H0N3YC4T/prototype-mk1/docs/keymap/keymap.png

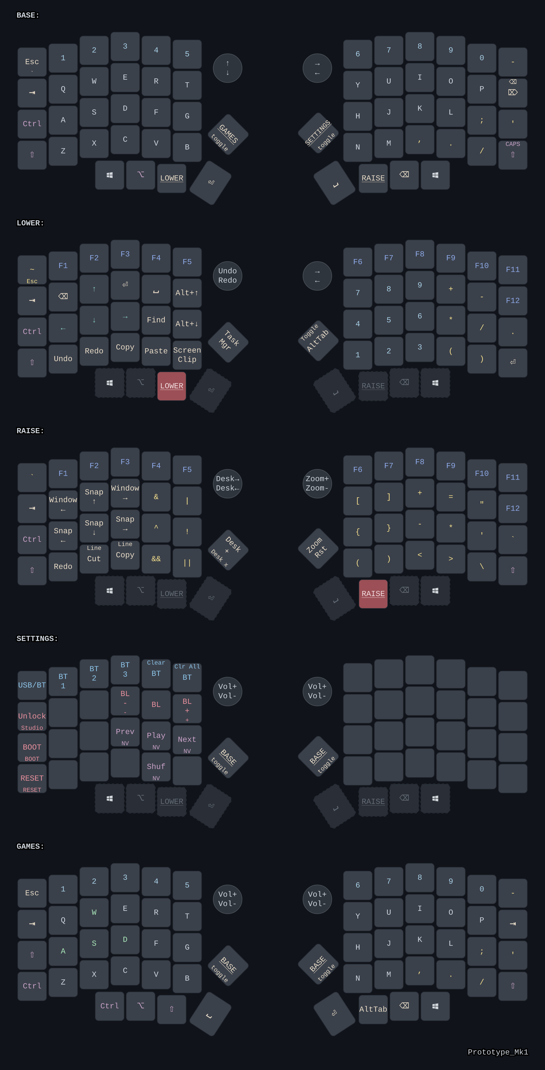
docs/keymap/keymap.png
