H0N3YC4T/prototype-mk1/docs/3d/keyboard.3mf

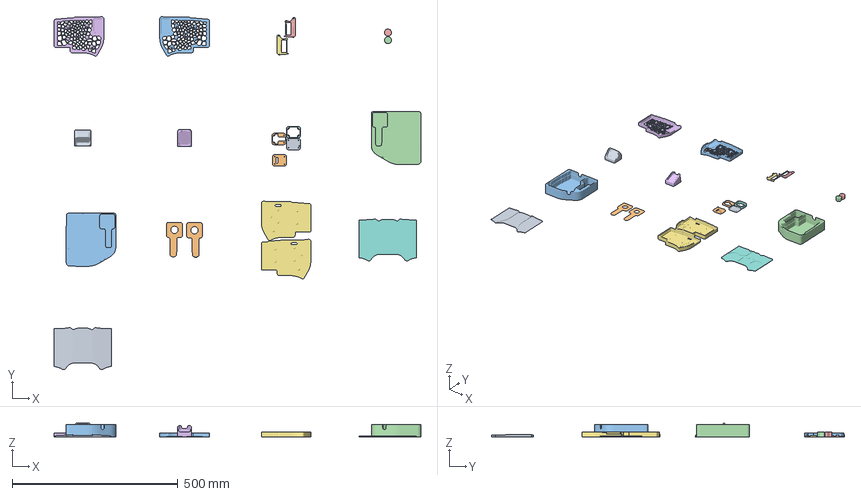
[picture p2: CAD file, 2026-10-10]
docs/3d/keyboard.3mf
1107.8 x 1066.5 x 43.7 mm
Assembly x 4
base x 2
dock_portrait
disp_mount.stl
Back
Middle
Keyboard_base
Body1_B x 2
Base - Part 8.stl
Base - Part 9.stl
