H0N3YC4T/prototype-mk1/docs/kicad_pcb.pdf

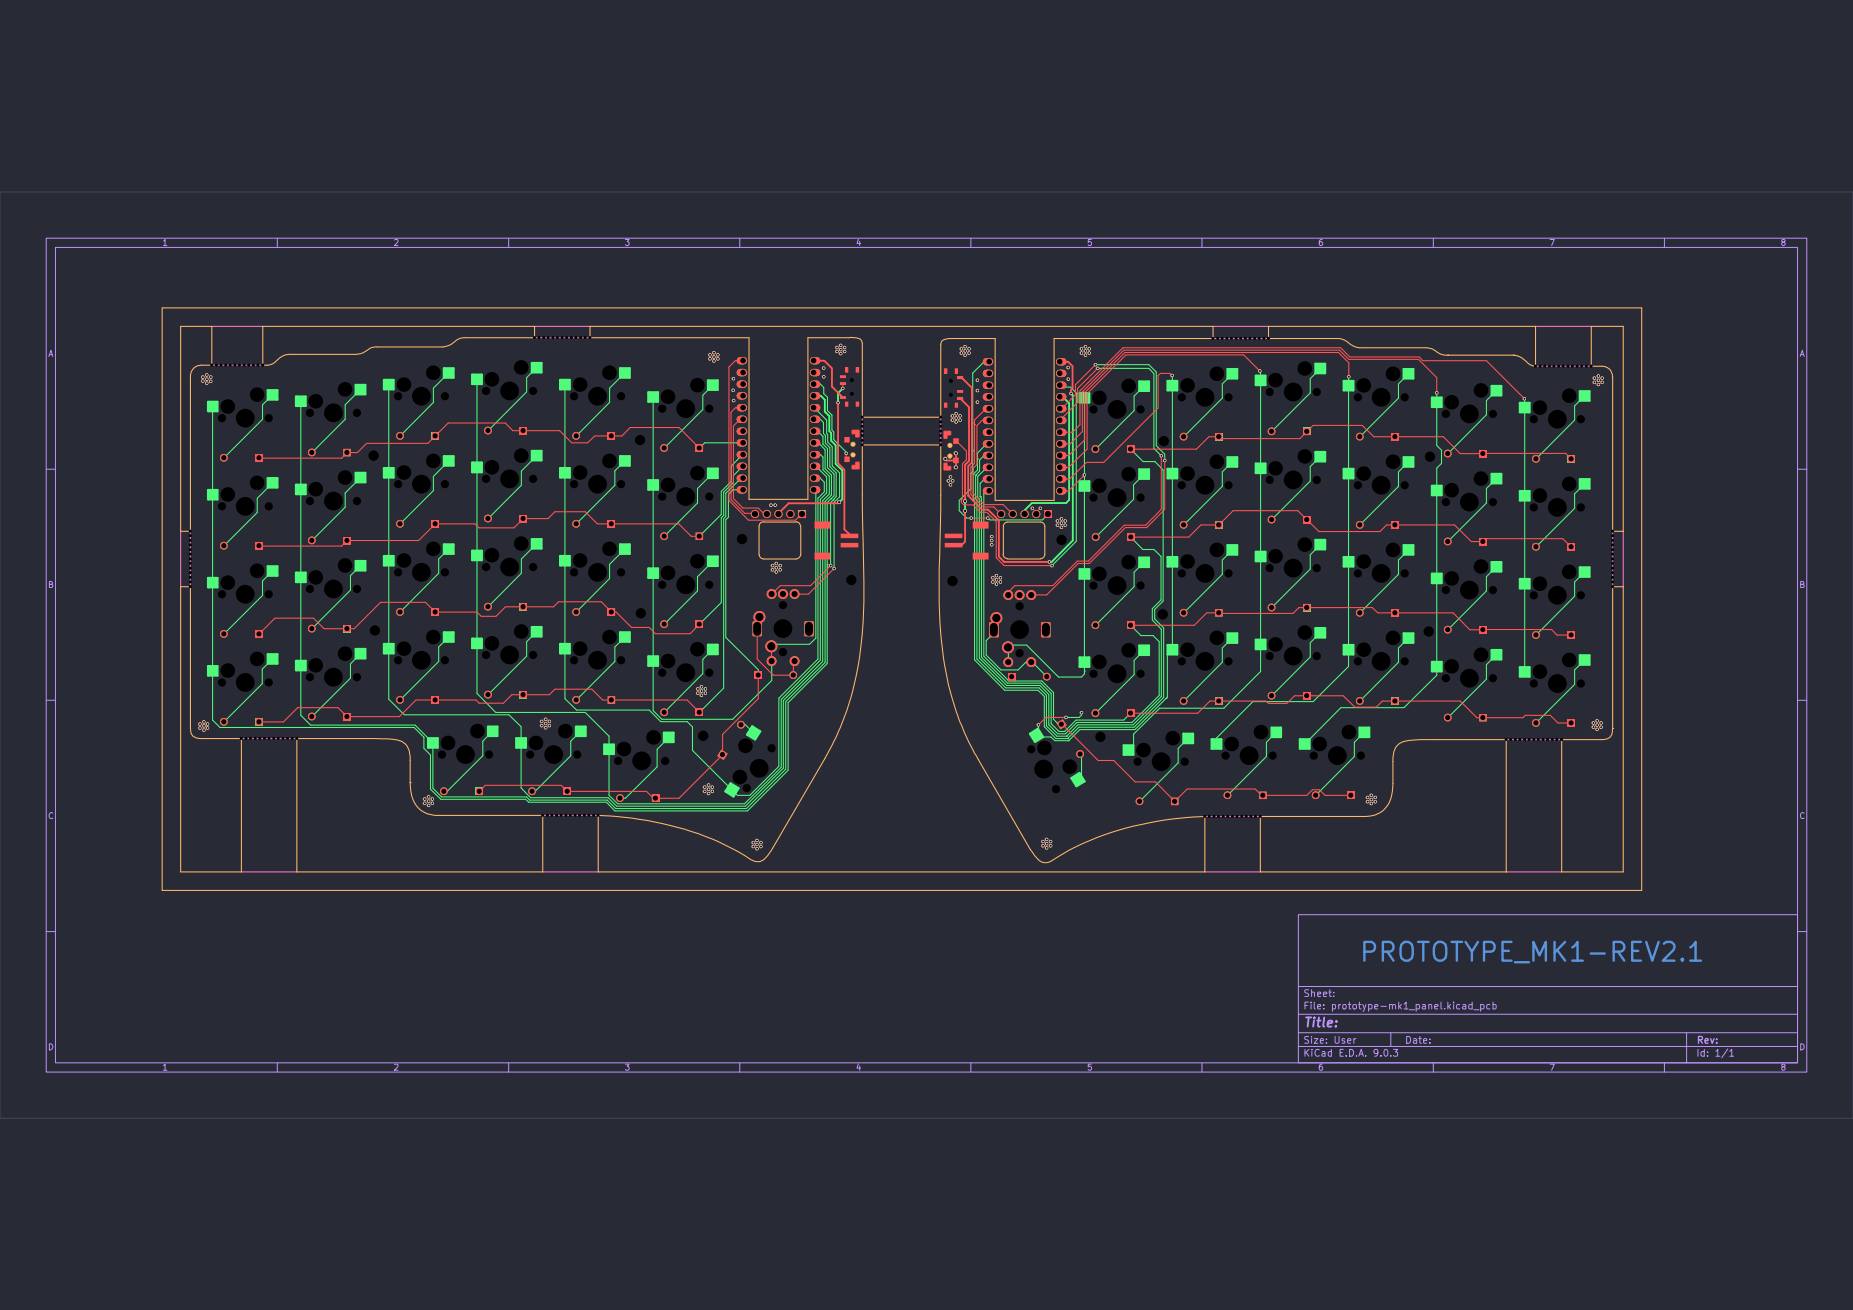
[picture p3: page 1]
