H0N3YC4T/prototype-mk1/docs/PCB/panel/GERBER_FILES/prototype-mk1_panel-B_Cu.pdf

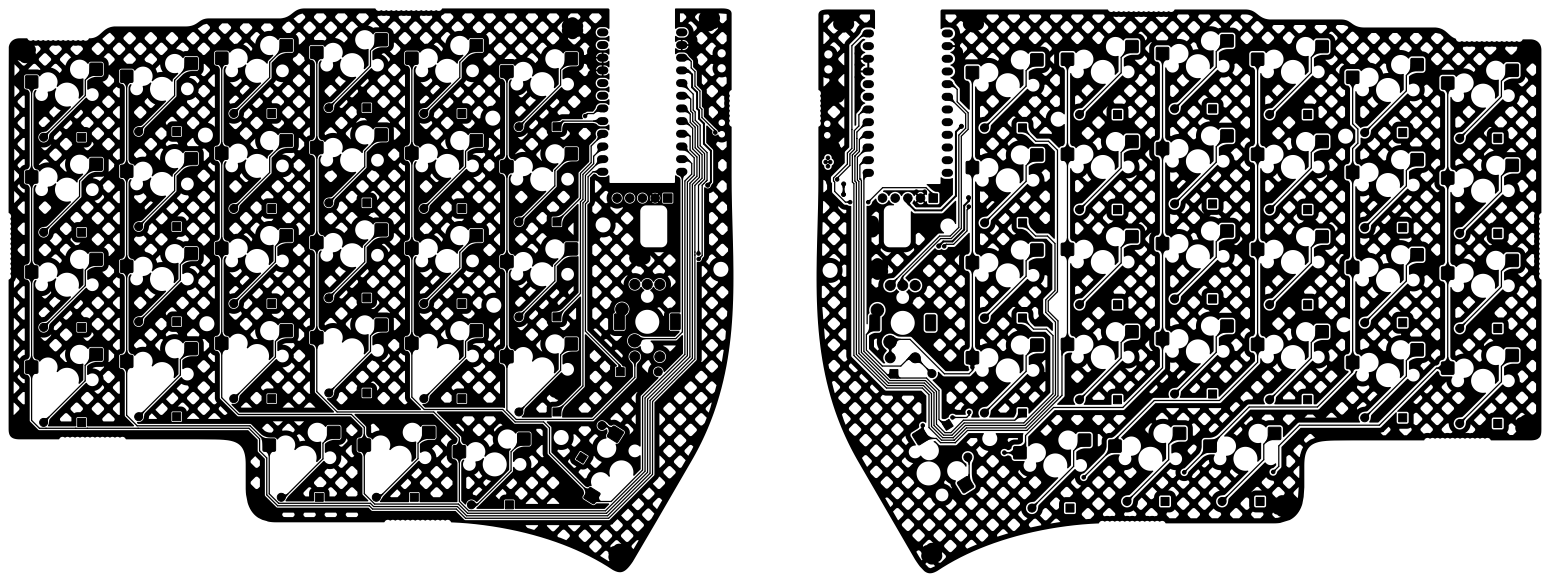
[picture p4: page 1]
