H0N3YC4T/prototype-mk1/docs/PCB/panel/GERBER_FILES/prototype-mk1_panel-B_Mask.pdf

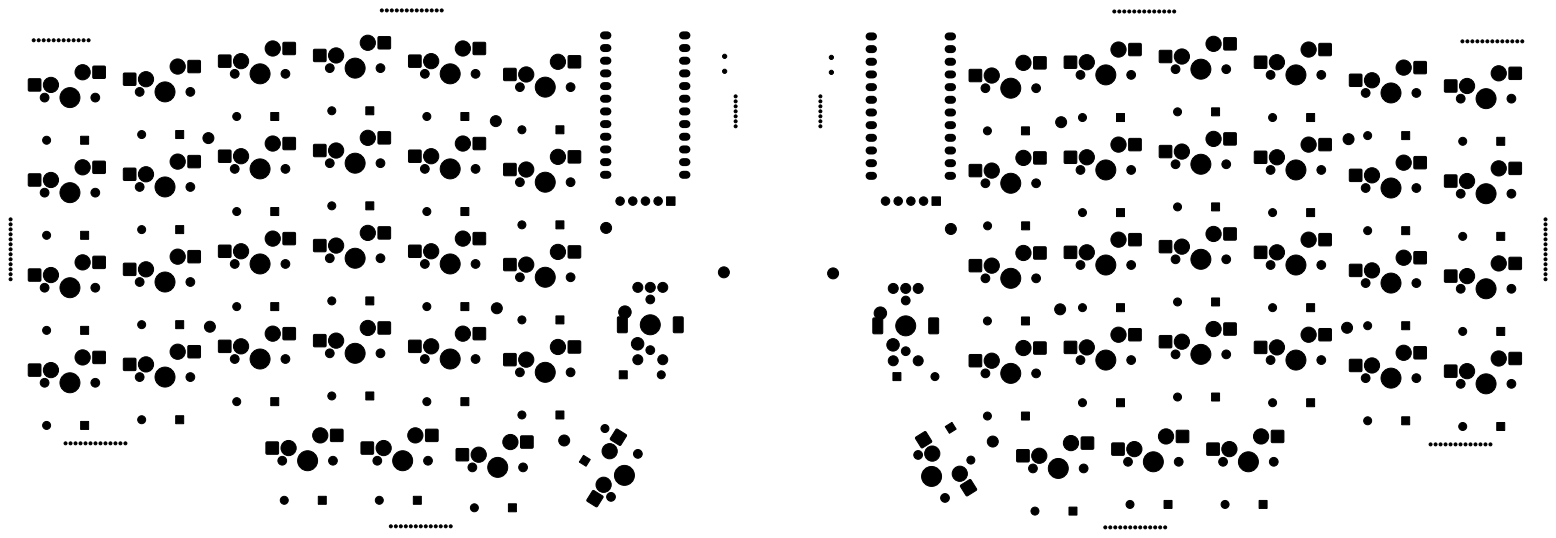
[picture p5: page 1]
