H0N3YC4T/prototype-mk1/docs/PCB/panel/GERBER_FILES/prototype-mk1_panel-B_Paste.pdf

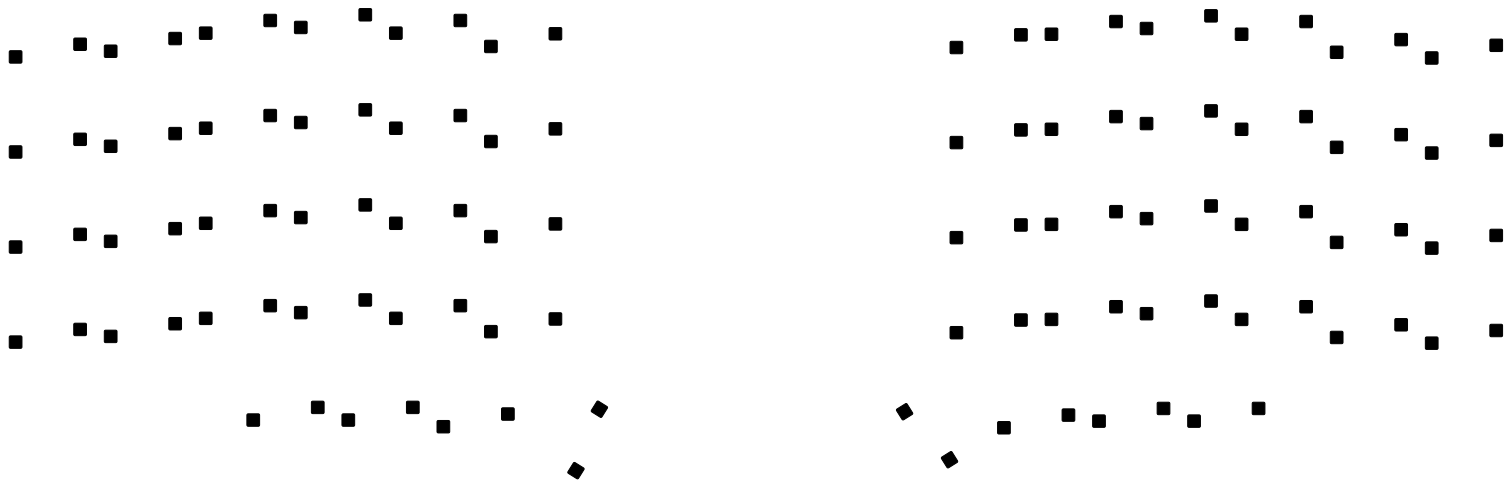
[picture p6: page 1]
