H0N3YC4T/prototype-mk1/docs/PCB/panel/GERBER_FILES/prototype-mk1_panel-Edge_Cuts.pdf

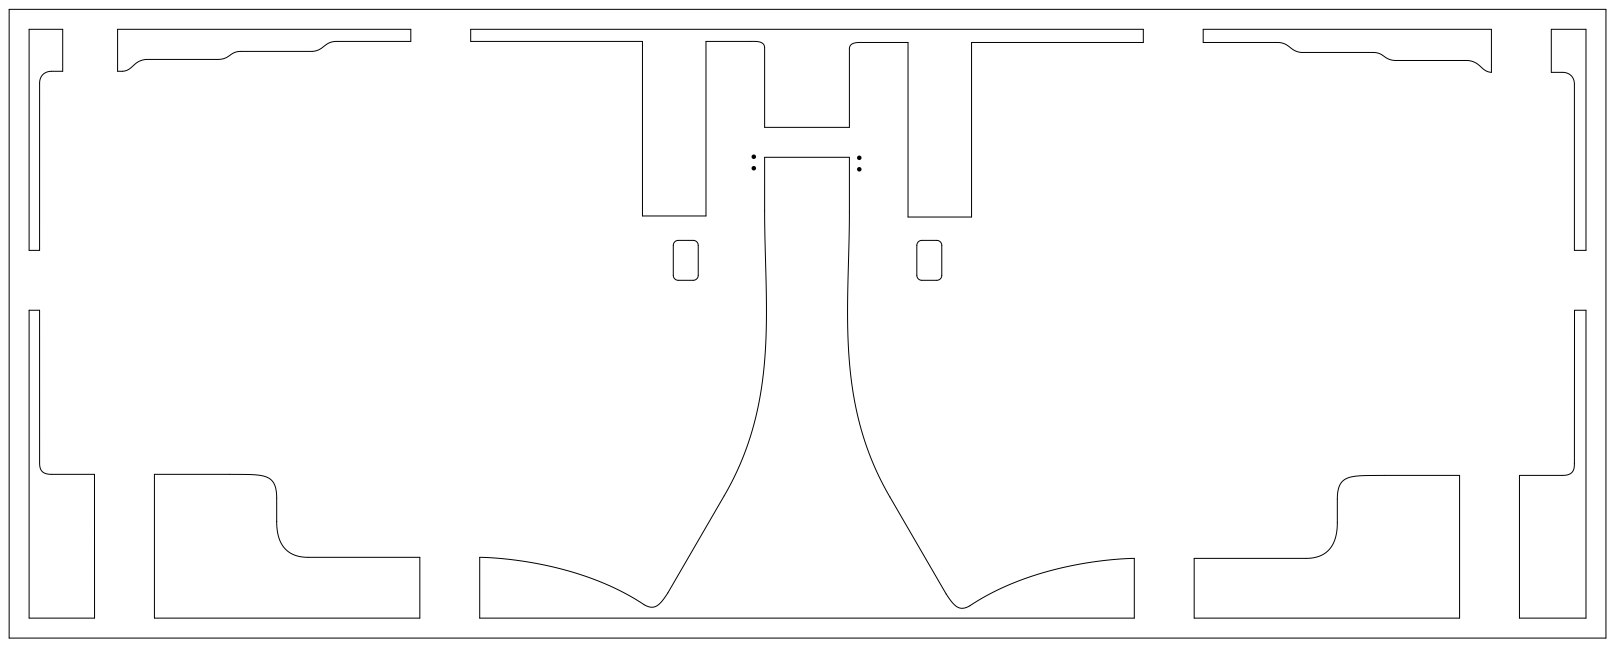
[picture p8: page 1]
