H0N3YC4T/prototype-mk1/docs/PCB/panel/GERBER_FILES/prototype-mk1_panel-F_Cu.pdf

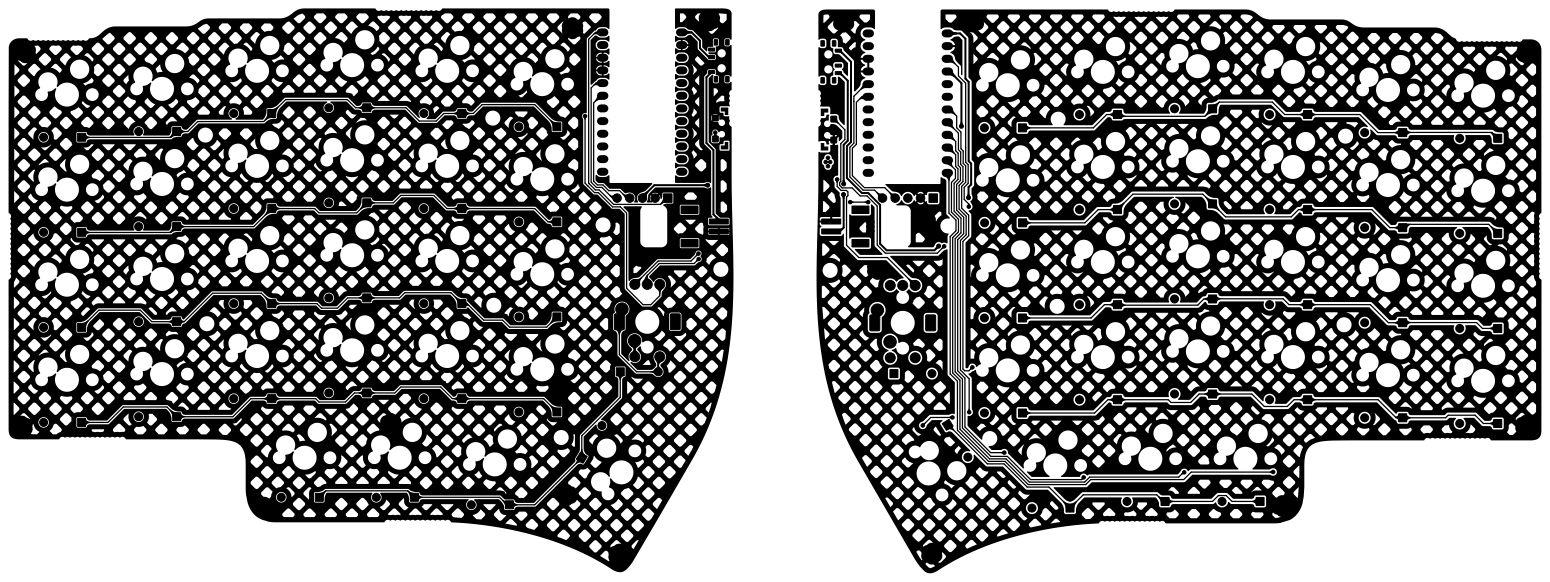
[picture p9: page 1]
