H0N3YC4T/prototype-mk1/docs/PCB/panel/GERBER_FILES/prototype-mk1_panel-F_Mask.pdf

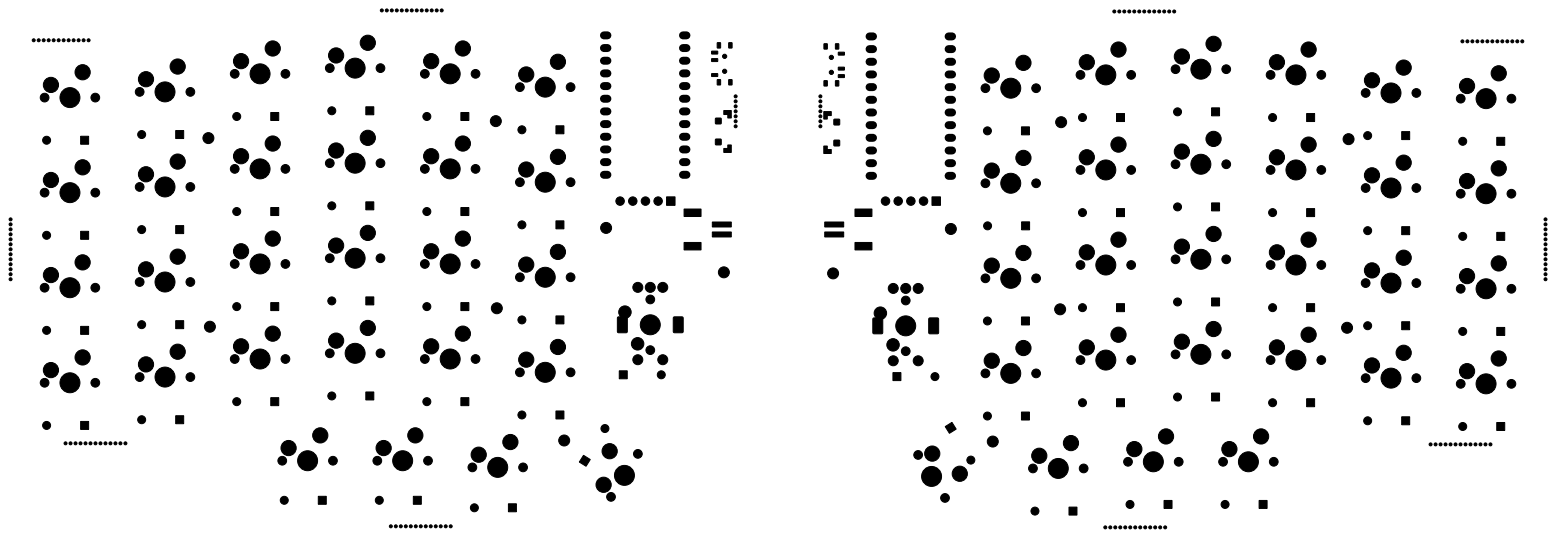
[picture p10: page 1]
