H0N3YC4T/prototype-mk1/docs/PCB/panel/GERBER_FILES/prototype-mk1_panel-F_Paste.pdf

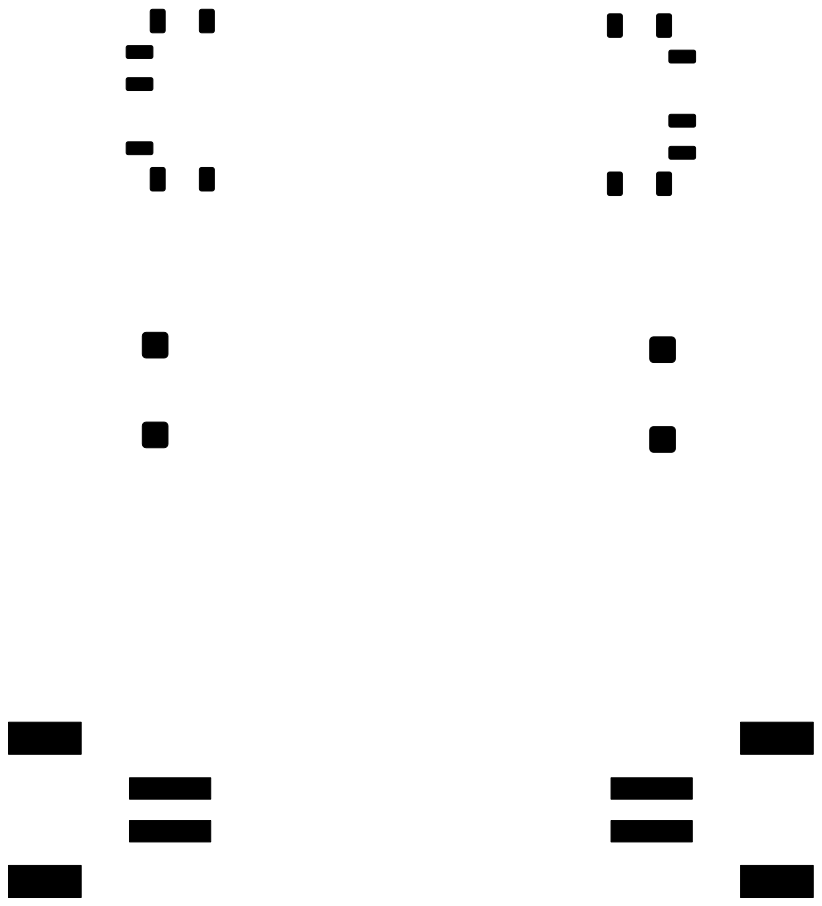
[picture p11: page 1]
