H0N3YC4T/prototype-mk1/docs/PCB/panel/GERBER_FILES/prototype-mk1_panel-F_Silkscreen.pdf

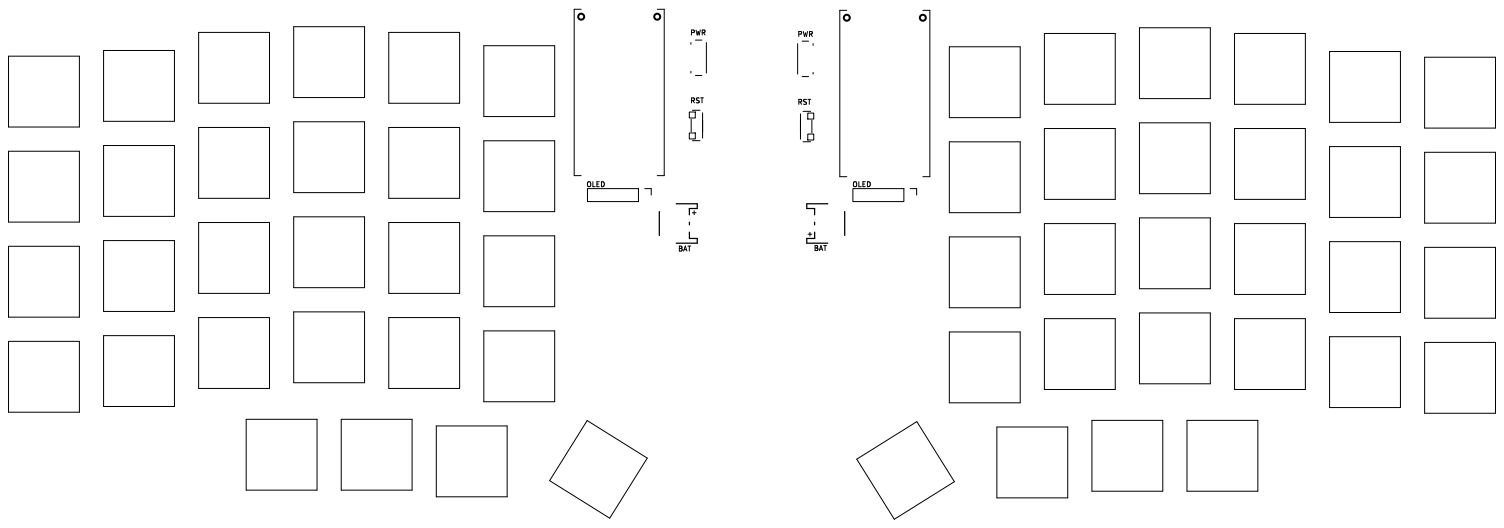
[picture p12: page 1]
