H0N3YC4T/prototype-mk1/docs/PCB/mounting_plate/prototype-mk1_top.kicad_sch

## KiCad design docs/PCB/mounting_plate/prototype-mk1_top.kicad_sch (2026-07-21)

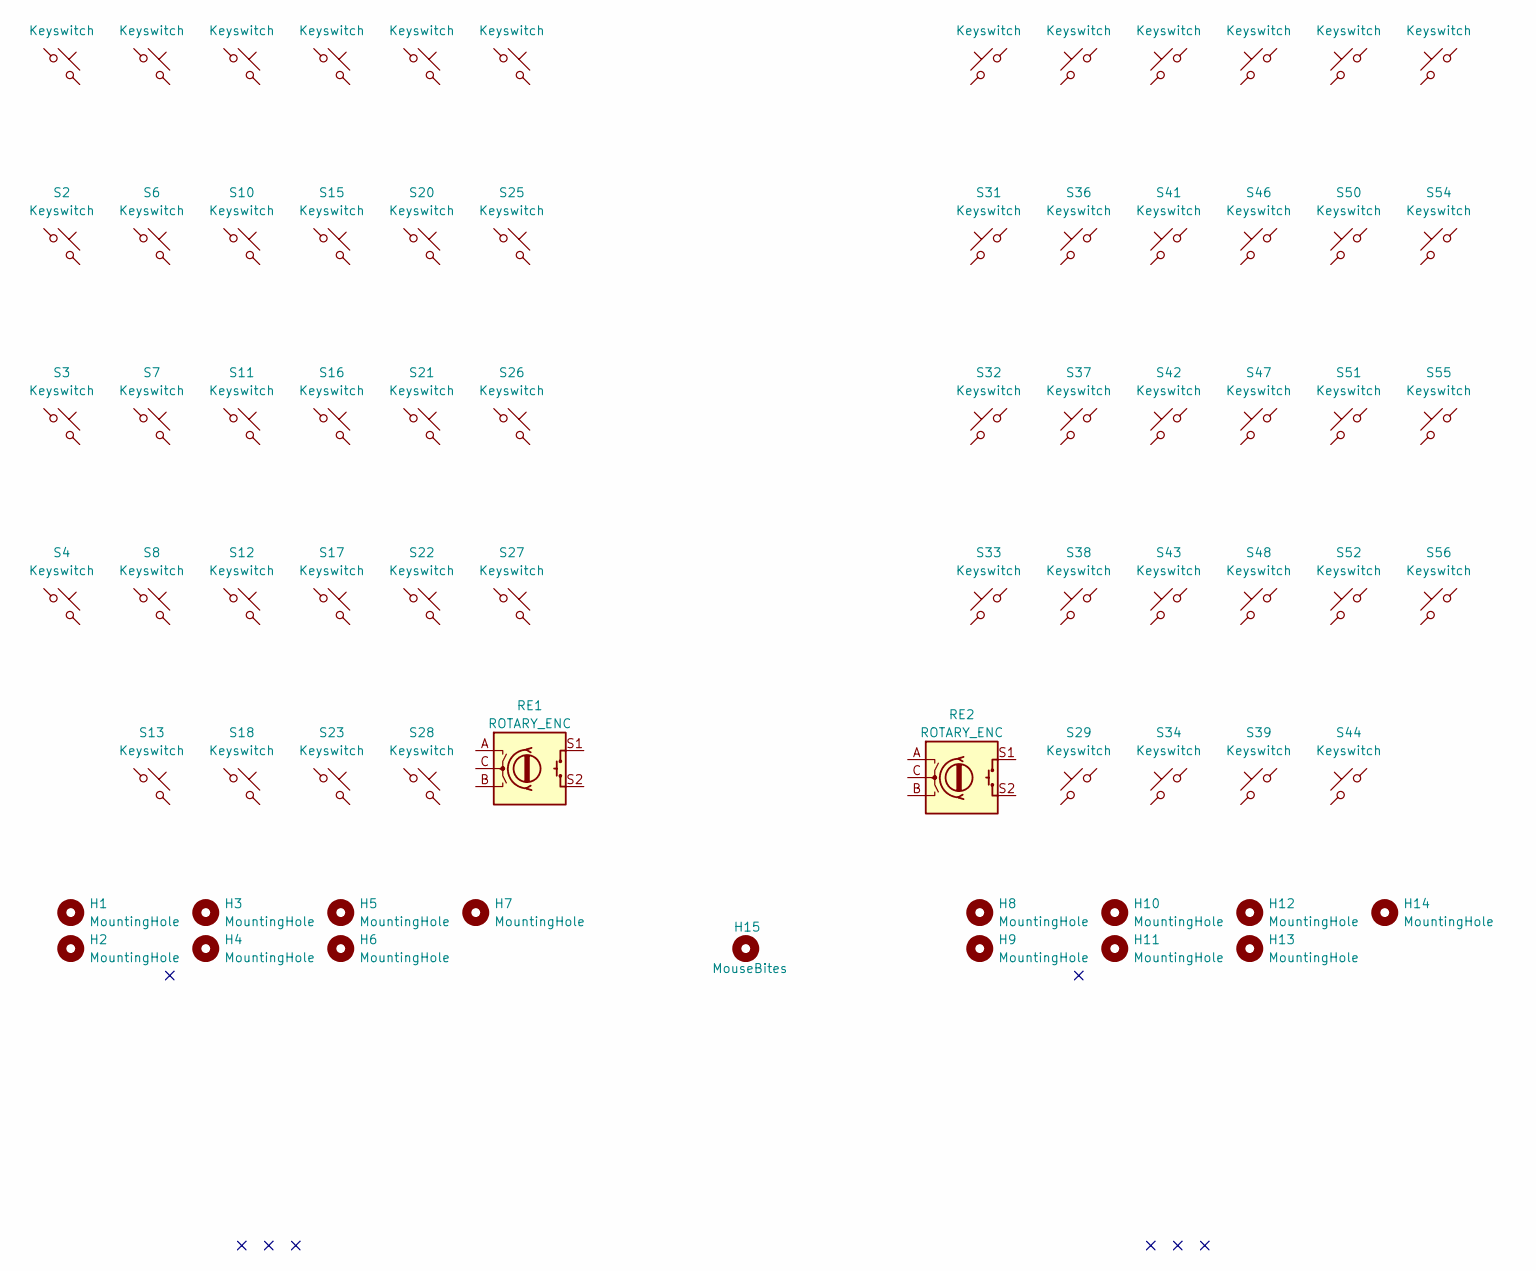
[picture p13: schematic prototype-mk1_top.kicad_sch]

Parts:
H1, H2, H3, H4, H5, H6, H7, H8, H9, H10, H11, H12, H13, H14: MountingHole; MountingHole_2.2mm_M2
H15: MouseBites; MountingHole_2.1mm
RE1, RE2: ROTARY_ENC; Encoder_EC11_MX_Combo
S1, S2, S3, S4, S5, S6, S7, S8, S9, S10, S11, S12, S13, S14, S15, S16, S17, S18, S19, S20, S21, S22, S23, S24, S25, S26, S27, S30, S31, S32, S33, S34, S35, S36, S37, S38, S39, S40, S41, S42, S43, S44, S45, S46, S47, S48, S49, S50, S51, S52, S53, S54, S55, S56: Keyswitch; Hotswap_MX_1.00u
S28, S29: Keyswitch; Hotswap_MX_1.50u
