H0N3YC4T/prototype-mk1/docs/PCB/panel/prototype-mk1_panel.kicad_sch

## KiCad design docs/PCB/panel/prototype-mk1_panel.kicad_sch (2026-07-21)

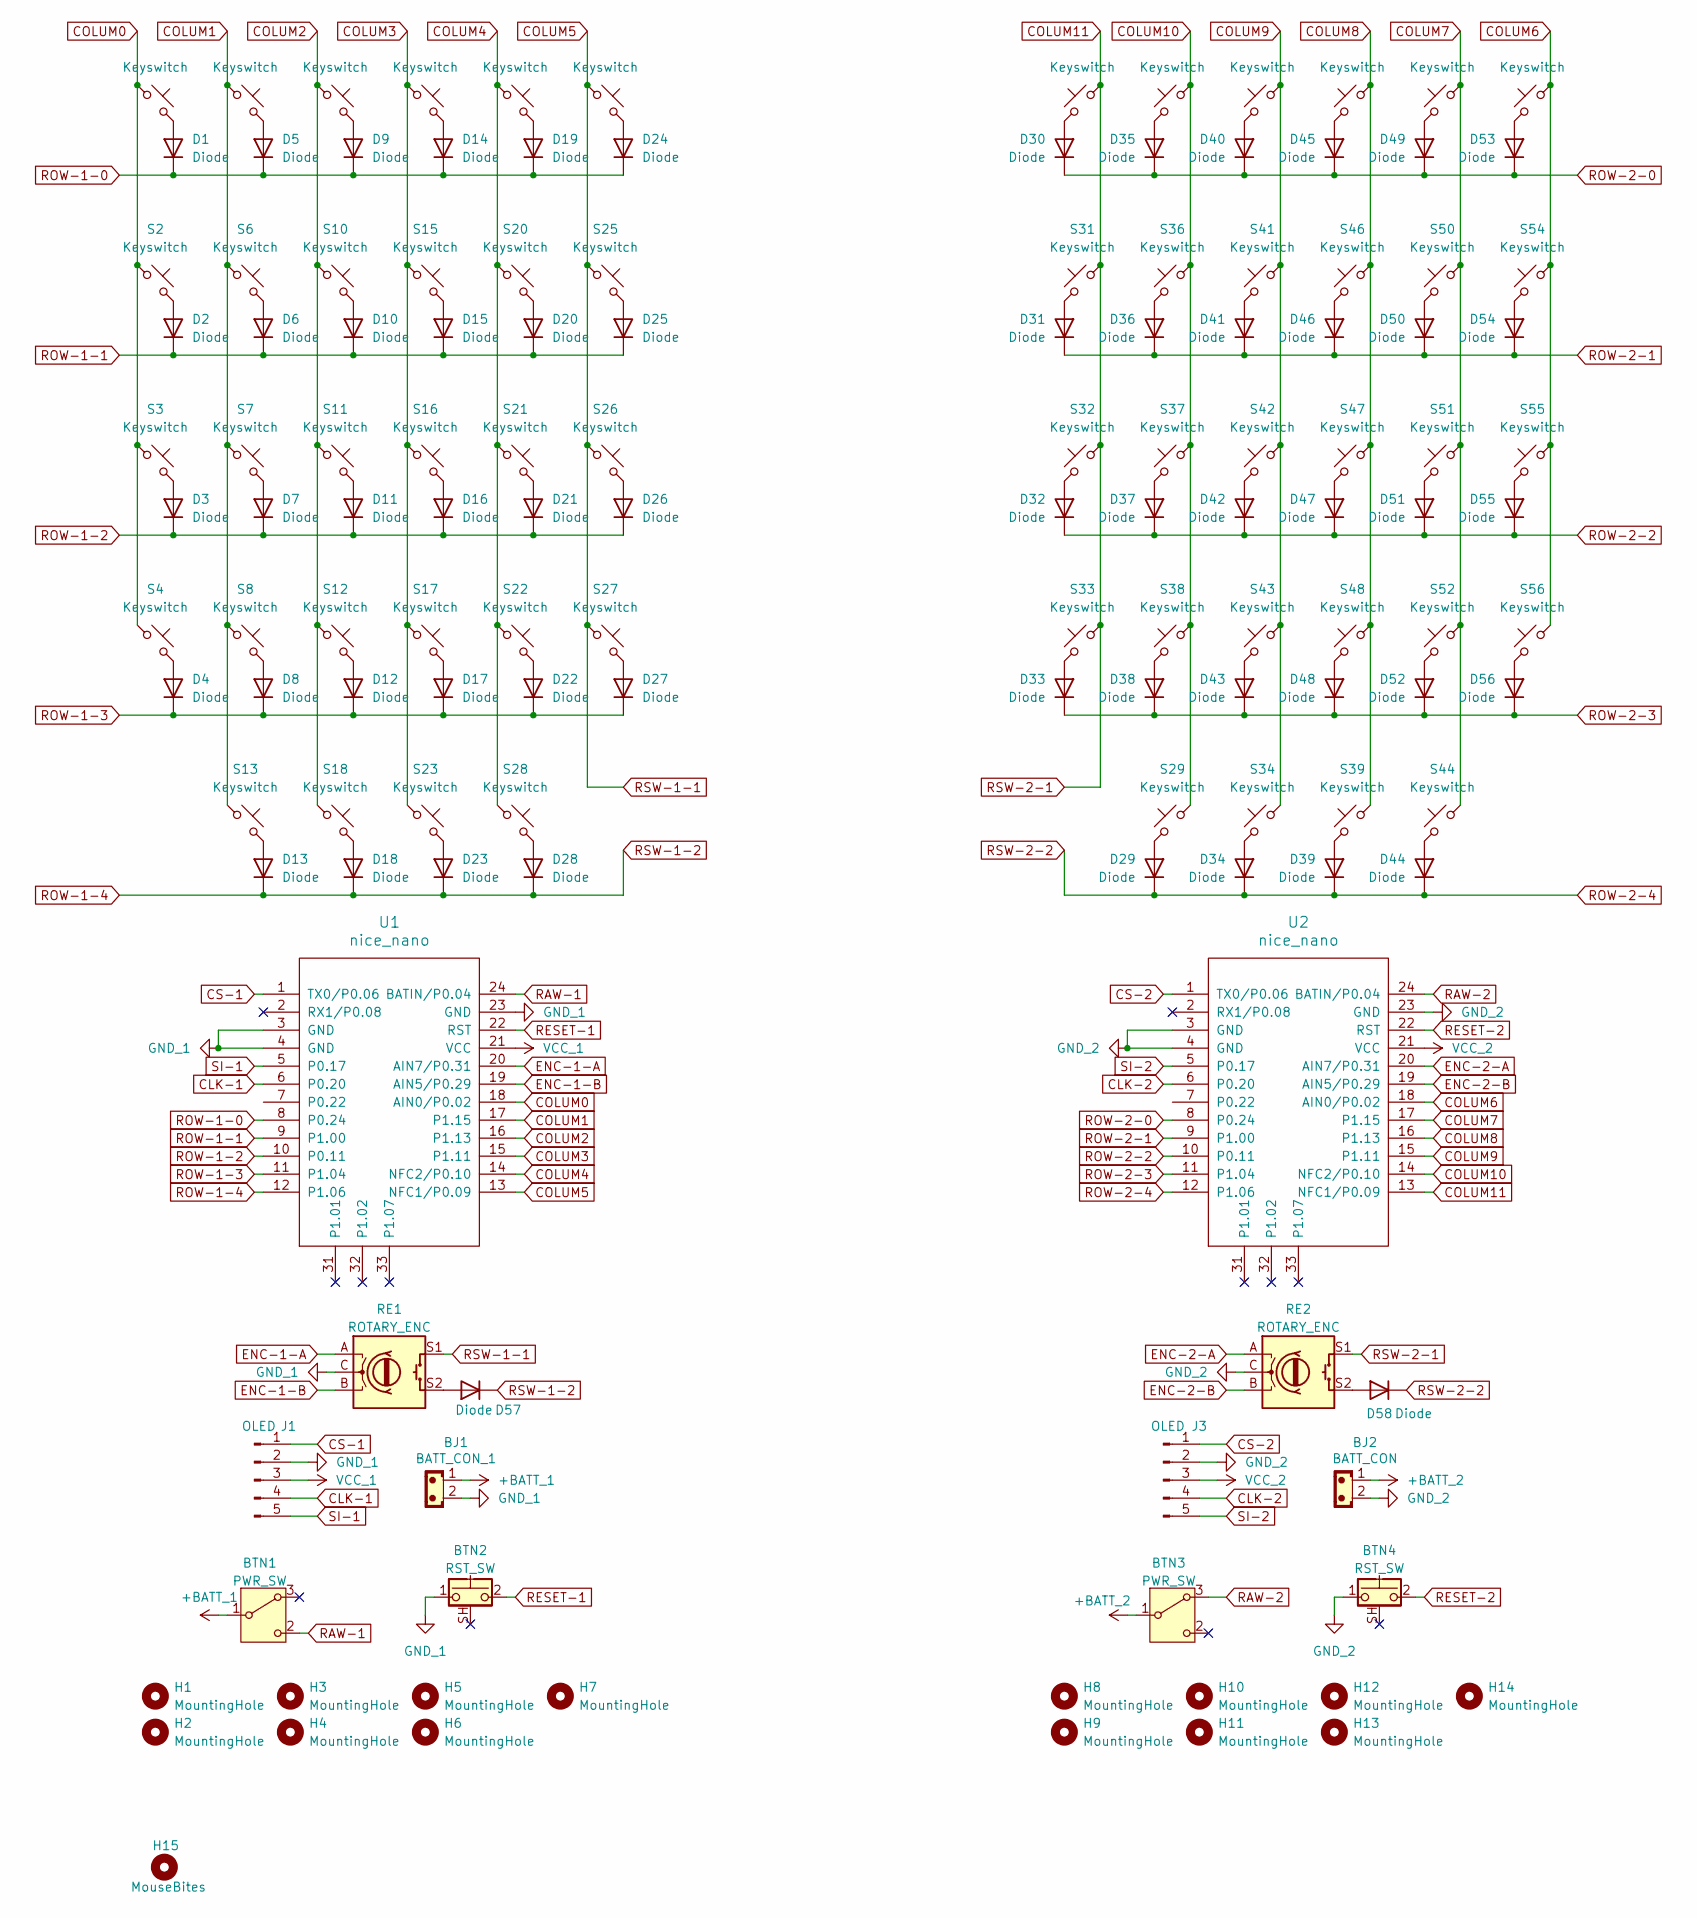
[picture p14: schematic prototype-mk1_panel.kicad_sch]

Parts:
BJ1: BATT_CON_1; Connector_1x02_JST-PH; LCSC C295747
BJ2: BATT_CON; Connector_1x02_JST-PH; LCSC C295747
BTN1, BTN3: PWR_SW; Switch_MSK12C02
BTN2, BTN4: RST_SW; Right-Angle_PushButton
D1, D2, D3, D4, D5, D6, D7, D8, D9, D10, D11, D12, D13, D14, D15, D16, D17, D18, D19, D20, D21, D22, D23, D24, D25, D26, D27, D28, D29, D30, D31, D32, D33, D34, D35, D36, D37, D38, D39, D40, D41, D42, D43, D44, D45, D46, D47, D48, D49, D50, D51, D52, D53, D54, D55, D56, D57, D58: Diode; Diode_DO-35
H1, H2, H3, H4, H5, H6, H7, H8, H9, H10, H11, H12, H13, H14: MountingHole; MountingHole_2.2mm_M2
H15: MouseBites; MountingHole_2.1mm
J1, J3: OLED; nice_view_LS011B7DH03
RE1, RE2: ROTARY_ENC; Encoder_EC11_MX_Combo
S1, S2, S3, S4, S5, S6, S7, S8, S9, S10, S11, S12, S13, S14, S15, S16, S17, S18, S19, S20, S21, S22, S23, S24, S25, S26, S27, S30, S31, S32, S33, S34, S35, S36, S37, S38, S39, S40, S41, S42, S43, S44, S45, S46, S47, S48, S49, S50, S51, S52, S53, S54, S55, S56: Keyswitch; Hotswap_MX_1.00u
S28, S29: Keyswitch; Hotswap_MX_1.50u
U1, U2: nice_nano; SuperMini NRF52840 - Edge_Mount

Connections:
+BATT_1: BJ1.1, BTN1.1 (B)
+BATT_2: BJ2.1, BTN3.1 (B)
CLK-1: J1.4 (CLK), U1.6 (P0.20)
CLK-2: J3.4 (CLK), U2.6 (P0.20)
COLUM0: S1.1, S2.1, S3.1, S4.1, U1.18 (AIN0/P0.02)
COLUM1: S5.1, S6.1, S7.1, S8.1, S13.1, U1.17 (P1.15)
COLUM2: S9.1, S10.1, S11.1, S12.1, S18.1, U1.16 (P1.13)
COLUM3: S14.1, S15.1, S16.1, S17.1, S23.1, U1.15 (P1.11)
COLUM4: S19.1, S20.1, S21.1, S22.1, S28.1, U1.14 (NFC2/P0.10)
COLUM5: RE1.S1, S24.1, S25.1, S26.1, S27.1, U1.13 (NFC1/P0.09)
COLUM6: S53.1, S54.1, S55.1, S56.1, U2.18 (AIN0/P0.02)
COLUM7: S44.1, S49.1, S50.1, S51.1, S52.1, U2.17 (P1.15)
COLUM8: S39.1, S45.1, S46.1, S47.1, S48.1, U2.16 (P1.13)
COLUM9: S34.1, S40.1, S41.1, S42.1, S43.1, U2.15 (P1.11)
COLUM10: S29.1, S35.1, S36.1, S37.1, S38.1, U2.14 (NFC2/P0.10)
COLUM11: RE2.S1, S30.1, S31.1, S32.1, S33.1, U2.13 (NFC1/P0.09)
CS-1: J1.1 (CS), U1.1 (TX0/P0.06)
CS-2: J3.1 (CS), U2.1 (TX0/P0.06)
ENC-1-A: RE1.A, U1.20 (AIN7/P0.31)
ENC-1-B: RE1.B, U1.19 (AIN5/P0.29)
ENC-2-A: RE2.A, U2.20 (AIN7/P0.31)
ENC-2-B: RE2.B, U2.19 (AIN5/P0.29)
GND_1: BJ1.2, BTN2.1, J1.2 (GND), RE1.C, U1.3 (GND), U1.4 (GND), U1.23 (GND)
GND_2: BJ2.2, BTN4.1, J3.2 (GND), RE2.C, U2.3 (GND), U2.4 (GND), U2.23 (GND)
unnamed: D1.2 (A), S1.2
unnamed: D2.2 (A), S2.2
unnamed: D3.2 (A), S3.2
unnamed: D4.2 (A), S4.2
unnamed: D5.2 (A), S5.2
unnamed: D6.2 (A), S6.2
unnamed: D7.2 (A), S7.2
unnamed: D8.2 (A), S8.2
unnamed: D9.2 (A), S9.2
unnamed: D10.2 (A), S10.2
unnamed: D11.2 (A), S11.2
unnamed: D12.2 (A), S12.2
unnamed: D13.2 (A), S13.2
unnamed: D14.2 (A), S14.2
unnamed: D15.2 (A), S15.2
unnamed: D16.2 (A), S16.2
unnamed: D17.2 (A), S17.2
unnamed: D18.2 (A), S18.2
unnamed: D19.2 (A), S19.2
unnamed: D20.2 (A), S20.2
unnamed: D21.2 (A), S21.2
unnamed: D22.2 (A), S22.2
unnamed: D23.2 (A), S23.2
unnamed: D24.2 (A), S24.2
unnamed: D25.2 (A), S25.2
unnamed: D26.2 (A), S26.2
unnamed: D27.2 (A), S27.2
unnamed: D28.2 (A), S28.2
unnamed: D29.2 (A), S29.2
unnamed: D30.2 (A), S30.2
unnamed: D31.2 (A), S31.2
unnamed: D32.2 (A), S32.2
unnamed: D33.2 (A), S33.2
unnamed: D34.2 (A), S34.2
unnamed: D35.2 (A), S35.2
unnamed: D36.2 (A), S36.2
unnamed: D37.2 (A), S37.2
unnamed: D38.2 (A), S38.2
unnamed: D39.2 (A), S39.2
unnamed: D40.2 (A), S40.2
unnamed: D41.2 (A), S41.2
unnamed: D42.2 (A), S42.2
unnamed: D43.2 (A), S43.2
unnamed: D44.2 (A), S44.2
unnamed: D45.2 (A), S45.2
unnamed: D46.2 (A), S46.2
unnamed: D47.2 (A), S47.2
unnamed: D48.2 (A), S48.2
unnamed: D49.2 (A), S49.2
unnamed: D50.2 (A), S50.2
unnamed: D51.2 (A), S51.2
unnamed: D52.2 (A), S52.2
unnamed: D53.2 (A), S53.2
unnamed: D54.2 (A), S54.2
unnamed: D55.2 (A), S55.2
unnamed: D56.2 (A), S56.2
unnamed: D57.2 (A), RE1.S2
unnamed: D58.2 (A), RE2.S2
RAW-1: BTN1.2 (C), U1.24 (BATIN/P0.04)
RAW-2: BTN3.3 (A), U2.24 (BATIN/P0.04)
RESET-1: BTN2.2, U1.22 (RST)
RESET-2: BTN4.2, U2.22 (RST)
ROW-1-0: D1.1 (K), D5.1 (K), D9.1 (K), D14.1 (K), D19.1 (K), D24.1 (K), U1.8 (P0.24)
ROW-1-1: D2.1 (K), D6.1 (K), D10.1 (K), D15.1 (K), D20.1 (K), D25.1 (K), U1.9 (P1.00)
ROW-1-2: D3.1 (K), D7.1 (K), D11.1 (K), D16.1 (K), D21.1 (K), D26.1 (K), U1.10 (P0.11)
ROW-1-3: D4.1 (K), D8.1 (K), D12.1 (K), D17.1 (K), D22.1 (K), D27.1 (K), U1.11 (P1.04)
ROW-1-4: D13.1 (K), D18.1 (K), D23.1 (K), D28.1 (K), D57.1 (K), U1.12 (P1.06)
ROW-2-0: D30.1 (K), D35.1 (K), D40.1 (K), D45.1 (K), D49.1 (K), D53.1 (K), U2.8 (P0.24)
ROW-2-1: D31.1 (K), D36.1 (K), D41.1 (K), D46.1 (K), D50.1 (K), D54.1 (K), U2.9 (P1.00)
ROW-2-2: D32.1 (K), D37.1 (K), D42.1 (K), D47.1 (K), D51.1 (K), D55.1 (K), U2.10 (P0.11)
ROW-2-3: D33.1 (K), D38.1 (K), D43.1 (K), D48.1 (K), D52.1 (K), D56.1 (K), U2.11 (P1.04)
ROW-2-4: D29.1 (K), D34.1 (K), D39.1 (K), D44.1 (K), D58.1 (K), U2.12 (P1.06)
SI-1: J1.5 (SI), U1.5 (P0.17)
SI-2: J3.5 (SI), U2.5 (P0.17)
VCC_1: J1.3 (VCC), U1.21 (VCC)
VCC_2: J3.3 (VCC), U2.21 (VCC)
