H0N3YC4T/prototype-mk1/(commit log)

2025-11-23 Updated prototype_mk1.keymap
2025-11-27 increase display art switching rate
2025-12-09 Enable Bluetooth Battery Service configuration
2025-12-20 Revert "Update prototype_mk1_dongle.conf"
    This reverts commit b2952b8cfd642f929cbe6983853a1c4b8de9e2cf.
2025-12-25 Add new board configuration for Seeeduino Xiao BLE
2025-12-25 Add configuration for prototype mk1 dongle
2025-12-25 Revert "Update prototype_mk1.keymap"
    This reverts commit 110fc3a6bd6e43e9def05b11e6d256bf8f2970a7.
2025-12-25 Revert "Update prototype_mk1.keymap"
    This reverts commit be50adc21cb6cdb8142dbabc005af247201384a0.
2025-12-25 Revert "Delete prototype_mk1_dongle.conf"
    This reverts commit 5c9ed228d39becadd1e383c954b757a51f5fc54a.
2026-02-19 ./boards, ./boards/shields
2026-03-10 fixed branches
    [prototype-mk1_panel.kicad_sch, prototype-mk1_shell.3mf, prototype-mk1_shell.step, prototype-mk1_shell.stl, prototype-mk1_shell_dongle.3mf, prototype-mk1_top.kicad_sch]
2026-04-21 Comment out left and right peripheral board entries
    Optimized for keymap changes
2026-06-23 Clean up project organization (non-functional)
    - Remove stale boards/shields/.gitkeep (directory is non-empty)
    - Remove duplicate nice_nano_nrf52840_zmk.overlay (byte-identical to
    nice_nano_v2.overlay; no build target uses that board name)
    - Sync shield-level prototype_mk1.keymap to match config/ (the canonical
    keymap that overrides it at build time), resolving the diverged copies
    - Fix copy-paste endif comment in Kconfig.defconfig (DONGLE -> CLEFT)
    No change to compiled firmware: matrix/GPIO/encoder mappings untouched,
    and the synced shield keymap is overridden by config/ at build time.
    Deferred to ZMK 4.x migration: OLED template residue, info.json vs
    physical-layout reconciliation,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
2026-06-23 Migrate build plumbing to Zephyr 4.1 (reset canary)
    Core manifest/board migration for the ZMK Zephyr 4.1 uplift:
    - west.yml: zmk revision v0.3-branch -> main (Zephyr 4.1, LVGL 9.3)
    - workflow: build-user-config.yml@v0.3 -> @main
    - build.yaml: board nice_nano_v2 -> nice_nano//zmk (HWMv2 board id)
    - rename shield board overlay nice_nano_v2.overlay -> nice_nano.overlay
    Build targets temporarily reduced to settings_reset only, as a plumbing
    canary that validates the manifest + workflow + board id with zero LVGL
    involvement. Display-bearing targets (dongle, periph_left/right) are
    commented out pending the LVGL 8 -> 9.3 widget migration, and will be
    re-enabled incrementally.
    Adds MIGRATION_NOTES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
2026-06-23 Modularize dongle_display via englmaxi module (LVGL 9)
    Replace the vendored boards/shields/dongle_display (old LVGL 8 snapshot of
    englmaxi/zmk-dongle-display) with a west.yml module reference to the
    upstream LVGL-9 / Zephyr-4.1 main. Your dongle config is stock, and the
    prototype_mk1_dongle.conf config symbols
    (ZMK_DONGLE_DISPLAY_LAYER_TEXT_ALIGN / _SCROLL_WIDTH) are unchanged
    upstream, so nothing is lost.
    - west.yml: add englmaxi remote + zmk-dongle-display project (revision main)
    - remove vendored boards/shields/dongle_display
    - build.yaml: re-enable the `dongle` target (nice_nano//zmk)
2026-06-23 Fix HWMv2 board-overlay name (nice_nano_nrf52840_zmk.overlay)
    Dongle build failed: "CONFIG_ZMK_BACKLIGHT is enabled but no zmk,backlight
    chosen node found". The shield's board overlay was renamed to
    nice_nano.overlay, which does not match the Zephyr 4.1 HWMv2 board target
    (nice_nano + nrf52840/zmk), so the PWM-backlight + WS2812-underglow overlay
    never applied. ZMK core shields (e.g. nice_view_adapter) name this file
    nice_nano_nrf52840_zmk.overlay; match that.
2026-06-23 Define dongle nice!view display in the dongle shield overlay
    Dongle build failed in src/display/main.c: DT_CHOSEN(zephyr_display)
    unresolved. englmaxi's dongle_display module ships only the status-screen
    widgets and intentionally has an empty overlay, expecting the dongle's own
    shield to define the display hardware. The removed vendored copy had carried
    the nice!view (Sharp LS0xx) node + chosen zephyr,display; move it to
    prototype_mk1_dongle.overlay on the nice_view_adapter &nice_view_spi bus.
2026-06-23 Order nice_view_adapter before dongle shield (DT label fix)
    DT parse error: undefined node label 'nice_view_spi'. That label is provided
    by the nice_view_adapter shield, but prototype_mk1_dongle (which references it
    for the display node) was listed before the adapter, so the label was not yet
    defined. Reorder the dongle build to list nice_view_adapter first, matching
    how nice_view_gem (also a &nice_view_spi consumer) sits after the adapter.
2026-06-23 Modularize nice_view_gem via M165437 module (LVGL 9)
    Replace the vendored boards/shields/nice_view_gem (old LVGL 8 snapshot of
    M165437/nice-view-gem) with a west.yml module reference to the upstream
    LVGL-9 / Zephyr-4.1 main, and re-enable the peripheral build targets.
    Per the agreed plan, the custom theme system (crystal+transmutation themes,
    the runtime theme API, and the hooks for the dormant cycle_animation
    behavior) is deferred and rebuilt later on the 4.x APIs. The custom theme
    code + artwork are preserved under deferred-features/nice_view_gem_theme/
    with a rebuild guide.
    - west.yml: add M165437 remote + nice-view-gem project (revision main)
    - remove vendored boards/shields/nice_view_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
2026-06-23 Pin zmk + display modules to validated commits
    Lock reproducibility now that all five targets build green on Zephyr 4.1 /
    LVGL 9.3. Pinned to the commits that were validated by CI:
    - zmk -> 64daf698e073e37b6748ac54f4eb48d8666af0b9
    - nice-view-gem -> 0a50fe209d929c916c5664c6affd0f4977c6b012
    - zmk-dongle-display -> 2bb333f87136d33e94a49d86236ed9ec254a8060
    Bump deliberately and re-test, per ZMK's pin-your-version guidance.
2026-06-23 Add XIAO + Waveshare prospector dongle (shared dongle base)
    Second dongle option: XIAO nRF52840 + Waveshare 1.69" color LCD via
    carrefinho/prospector-zmk-module (feat/new-status-screens), OPERATOR theme.
    Refactor the receiver-dongle DT into a shared base so the existing nice!view
    dongle is untouched functionally while the XIAO dongle reuses the matrix
    transform:
    - prototype_mk1_dongle_base.dtsi: mock kscan + dongle transform + central chosen
    - prototype_mk1_dongle.overlay: base + nice!view display + encoders (nice!nano)
    - prototype_mk1_waveshare.overlay: base only; display comes from prospector_adapter
    - prototype_mk1_waveshare.conf: OPERATOR theme; fixed brightness, ambient sensor
    off (t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
2026-06-23 Gem custom theme system + images (crystal + transmutation)
    Layer the custom theme system onto the stock LVGL-9 gem (step 1 of the custom
    feature; the hotkey wiring follows):
    - bring in the theme-aware animation.c + animation.h + animation_assets.c/h
    (LVGL-9 compatible as-is; they use the same compat APIs as the stock gem)
    - convert the custom crystal (16) + transmutation (11) frame descriptors from
    LVGL 8 to LVGL 9 (LV_IMG_CF_INDEXED_1BIT -> LV_COLOR_FORMAT_I1, drop
    always_zero/reserved); drop the stock single-crystal asset
    - CMakeLists: compile the themed frames + animation_assets on the peripheral path
    - Kconfig.defconfig: NICE_VIEW_ANIMATION / _MS + a theme choice
    (transmutation d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
2026-06-23 Wire cycle_animation hotkey to switch nice!view theme
    Revive the dormant cycle_animation behavior and connect it to the gem theme
    system so a key can change the peripheral animation theme / toggle movement at
    runtime:
    - root CMakeLists.txt: compile app/src/behaviors/behavior_cycle_animation.c and
    app/src/events/cycle_animation_state_changed.c (previously never built); the
    behavior self-guards on its DT compatible
    - remove the inert, misspelled app/CMakeList.txt (never processed)
    - keymap: declare the cycle_animation behavior node + NVC_TOGGLE/NVC_NEXT defines,
    and bind &cycle_animation NVC_NEXT / NVC_TOGGLE on the SETTINGS layer
    - gem animation.c: subscribe to cycle_animation_state_cha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
2026-06-23 updating theme switching
2026-06-23 Fix cycle_animation behavior init level (APPLICATION -> POST_KERNEL)
    BEHAVIOR_DT_INST_DEFINE passed APPLICATION as the device init level, but
    Zephyr 4.1's Z_DEVICE_CHECK_INIT_LEVEL only accepts PRE_KERNEL_1/2 or
    POST_KERNEL for devices, so APPLICATION expanded to a ZERO_OR_COMPILE_ERROR.
    All upstream ZMK behaviors use POST_KERNEL.
2026-06-23 Split transmutation theme into landscape + evangelion
    The "transmutation" theme was a mislabeled mix of two image sets. Split it into
    two properly-named themes (the underlying frames stay in transmutation.c, now
    documented per-image):
    - landscape: 01 dunes, 03 dunes 2, 06 pyramids, 07 mountain, 08 mountains 2
    - evangelion: 02/04/05 spaceships, 09/10/11 evangelion
    Themes are now crystal / landscape / evangelion. Updates:
    - animation.h: nice_view_theme enum (crystal, landscape, evangelion)
    - animation_assets.c: landscape_imgs[] + evangelion_imgs[] + lookup tables
    - animation.c: default-theme selection + bounds fallback
    - Kconfig.defconfig: theme choice (default crystal)
    - transmutation.c: pe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
2026-06-23 Split transmutation.c into landscape.c + evangelion.c
    Finish the rename: the shared transmutation.c is split into two per-theme
    files with matching symbol prefixes (frame numbers preserved):
    - landscape.c: landscape_01/03/06/07/08 (dunes, pyramids, mountains)
    - evangelion.c: evangelion_02/04/05/09/10/11 (spaceships, evangelion)
    animation_assets.c now declares/uses the new symbol names; CMakeLists compiles
    the two new files. No "transmutation" identifiers remain.
2026-06-23 Add transmutation, omnissiah, ultramar animation themes
    Import three re-imported animations as themes (32 frames each), converted
    from LVGL 8 to LVGL 9 (LV_IMG_CF_INDEXED_1BIT -> LV_COLOR_FORMAT_I1, dropped
    always_zero/reserved):
    - transmutation (120x68) — the original proper animation
    - omnissiah (69x68)
    - ultramar (69x68)
    Wired into the theme system: enum + Kconfig choices + CMakeLists sources, and
    animation_assets.c regenerated for all six themes (crystal, landscape,
    evangelion, transmutation, omnissiah, ultramar). The hotkey cycles all six.
    Note: transmutation frames are in file/symbol order (01..32); their source
    labels (F0,F1,F3,F5,F2..) are not sequential, so play order may need a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
2026-06-24 Per-theme animation speed (slideshows vs animations)
    landscape and evangelion are slideshows (slow per-image dwell); crystal,
    transmutation, omnissiah, ultramar are animations (fast/smooth). Replace the
    single global NICE_VIEW_ANIMATION_MS with a per-theme per-frame dwell array
    (nice_view_anim_frame_ms); loop duration = dwell * frame_count, so the speed is
    stable as frames are added/removed.
    - slideshows: 5000 ms/frame; animations: 60 ms/frame
    - animation_assets.c/.h: new nice_view_anim_frame_ms[] table
    - animation.c: use it for lv_animimg duration
    Also notes: future features (XIAO display-brightness behavior + touch wiring).
2026-06-24 Tune animation/slideshow speeds (30 fps / 15 s per frame)
    Animations (crystal, transmutation, omnissiah, ultramar) -> 33 ms/frame (~30 fps).
    Slideshows (landscape, evangelion) -> 15000 ms/frame (one image every 15 s).
2026-06-24 Finish gem: default theme = transmutation, drop deferred-features
    - Kconfig: default peripheral theme set to transmutation (the new 32-frame
    animation), per user. The hotkey still cycles all six.
    - Transmutation play order confirmed correct as-is (incremental 01..32; the F#
    comments are just source filenames).
    - Remove deferred-features/nice_view_gem_theme/ — the LVGL-8 holding pen from
    the migration; fully superseded by the rebuilt gem and preserved in git history.
2026-06-24 Keymap fixes + 3-way cycle_animation (next/prev/pause)
    - Layer #defines corrected to match actual indices: remove ARROWS/MOUSE,
    GAMES = 4 (0 base, 1 lower, 2 raise, 3 settings, 4 games).
    - Add &bootloader on the Settings layer at the Z position.
    - Replace the broken bare &cycle_animation with three working controls on the
    Settings layer: backwards / pause / forwards.
    cycle_animation now has three commands (behavior + event + gem listener):
    - NVC_NEXT : forwards -> next theme, resume play
    - NVC_PREV : backwards -> previous theme, resume play
    - NVC_PAUSE : freeze on a random static frame of the current theme
    Updated Studio metadata accordingly. Shield keymap copy re-synced with config.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
2026-06-24 Review cleanup: drop vestigial OLED/SSD1306 + dead Kconfigs + stale notes
    No functional change to the keyboard; clears migration residue found in a
    full review against the pre-migration baseline (load-bearing DT/configs all
    verified identical: matrix transform, GPIOs, backlight, underglow, dongle
    transform, BT/sleep/battery).
    - prototype_mk1/Kconfig.defconfig: remove the vestigial `if ZMK_DISPLAY ->
    I2C=y/SSD1306=y` forcing (SSD1306-template leftover; the displays are SPI
    nice!view, not I2C OLED). Kills the SSD1306 build warning + dead driver.
    - prototype_mk1.yml: drop `exposes: [i2c_oled]` (no I2C OLED on this shield).
    - nice_view_gem/Kconfig.defconfig: remove dead configs unreferenced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
2026-06-24 TEMP debug: enable USB serial logging on the waveshare dongle
    Diagnosing "battery shows but no keys" on the XIAO/prospector dongle. The
    nice!nano dongle (identical key path) types fine, and holding a layer key does
    not change the prospector layer indicator -> the XIAO central isn't receiving
    key-position notifications from the peripherals (battery uses a separate active
    GATT read, so it still works).
    CONFIG_ZMK_USB_LOGGING + ZMK_LOG_LEVEL=4 (DBG) so we can watch the split central
    connect/subscribe and (not) receive position notifications over the XIAO's USB
    serial. Only affects dongle-waveshare. Revert once diagnosed.
2026-06-24 Fix waveshare dongle no-keys (ZMK #3156) + transmutation-only gem
    Deep-dived the whole key path: the waveshare dongle config is byte-equivalent to
    the working nice!nano dongle (same keymap, transform, physical layout, split
    role, peripherals; neither board overrides BT_ATT_TX_COUNT). The no-keys is ZMK
    #3156: with battery-level fetching on, the central's concurrent GATT discovery
    of BOTH peripherals shares one ATT TX pool and the battery discovery races the
    key-position discovery to exhaustion -> battery shows, no keys, on BOTH halves.
    The heavy prospector colour display on the XIAO tightens the timing so ZMK's
    default BT_ATT_TX_COUNT=10 is not enough (the nice!nano's light mono display has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
2026-06-25 Docs: refresh MIGRATION_NOTES with current status + the #3156 dongle fix
    The scratchpad still described the migration as in-progress. Add a CURRENT
    STATUS block: 6 targets green, the waveshare no-keys root cause + fix (ZMK
    #3156 / BT_ATT_TX_COUNT), the TEMP transmutation-only gem state, the touch dev
    branches, and the open decisions (Studio, deprecated labels, bks_del, prospector
    pin). Doc-only.
2026-06-26 Remove ZMK Studio + bks_del; drop deprecated label props
    - Studio: it was enabled but unusable (no studio_unlock key, no USB-RPC snippet)
    -> dead flash. Removed CONFIG_ZMK_STUDIO=y (config/prototype_mk1.conf), the
    commented Studio block (shield conf), and the `studio` feature (prototype_mk1.yml).
    - bks_del: unbound mod-morph behaviour -> removed (del_bks is the bound one, kept).
    - Deprecated `label` props: removed all 18 from behaviors/macros/keymap layers.
    ZMK 4.1 deprecates `label`; the layers already carry `display-name` (what the
    prospector/gem read), so dropping `label` clears the warnings with no loss.
    Shield keymap copy re-synced.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
2026-06-26 Add diagnostic dongle-waveshare variants for the no-keys A/B test
    Deep dive into ZMK's split central (app/src/split/bluetooth/central.c) confirms
    the no-keys mechanism: discovery starts immediately on connect over the full
    GATT range for both peripherals concurrently, and the key-position
    characteristic is only subscribed if discovery reaches it before aborting. With
    battery-fetch on, the extra battery subscribe+read competes for the ATT TX pool
    (#3156); on the XIAO the heavy prospector display makes it deterministic.
    Two temporary build variants to localise it on hardware in one CI run:
    - dongle-waveshare-nobat: BATTERY_LEVEL_FETCHING=n (removes the competing
    discovery). Types here but n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
2026-06-27 Add XIAO settings_reset build to clear stale dongle bonds
    Serial log from the waveshare dongle shows the real cause of "no keys": the
    central DOES find + subscribe to the key-position characteristic, then security
    fails -- "level 1 err 2" (BT_SECURITY_ERR_PIN_OR_KEY_MISSING) -- and the
    subscription is torn down. That's a BLE bond key mismatch between the XIAO and
    the halves, not ZMK #3156 (battery-fetch was a red herring).
    Resetting the halves never fixed it because a UF2 flash doesn't wipe the
    settings/NVS partition, so the XIAO kept stale bonds from earlier attempts, and
    the existing `reset` artifact is nice_nano-only. Add a xiao_ble settings_reset
    (reset-waveshare) so the XIAO's bonds ca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
2026-06-27 Clean up dongle debugging; document 3 BT profiles; sync keymap
    Dongle no-keys is fixed (stale XIAO BLE bond; cleared via the new
    reset-waveshare settings_reset). Remove the now-unneeded debugging scaffolding
    and correct the record:
    - build.yaml: drop the diagnostic dongle-waveshare-nobat / -log variants. Keep
    reset-waveshare (settings_reset for the XIAO -- the utility that fixes the
    stale-bond case).
    - prototype_mk1_waveshare.conf: drop CONFIG_BT_ATT_TX_COUNT=20 (it was the
    #3156 buffer theory, which was a red herring -- the cause was the bond).
    - Kconfig.defconfig: document that the waveshare already yields exactly 3 host
    BLE profiles (BT_MAX_PAIRED 5 - 2 peripherals), matching the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
2026-06-27 west: point prospector at our fork (custom OPERATOR theme)
    Switch the prospector-zmk-module project from carrefinho to our fork
    H0N3YC4T/prospector-zmk-module @ feat/new-status-screens, which now carries the
    custom OPERATOR theme work (first change: lilac WPM bars/text). Tracked while we
    iterate; pin to a SHA once the theme settles.
2026-06-27 west: pin prospector fork to a21074e (battery 3-tier colours)
    Pins the prospector fork to the commit adding per-half 3-tier battery colours
    (blue >60 / yellow 30-60 / red <30) on top of the lilac WPM. Pinning per
    iteration triggers CI and keeps the build reproducible.
2026-06-28 settings layer: restore theme switching + relay backlight from waveshare dongle
    Theme switching: NICE_VIEW_GEM_TRANSMUTATION_ONLY is now a real toggle defaulting
    to n, so all six gem themes compile and cycle_animation (next/prev) cycles them
    again. The animation.c lock that forced the gem to transmutation is gated on the
    same symbol (set =y to slim the build back to transmutation-only).
    Backlight: &bl is GLOBAL-locality and relays to the halves, but the XIAO dongle
    had CONFIG_ZMK_BACKLIGHT disabled (no backlight LED -> BUILD_ASSERT). Keep it
    enabled and add a placeholder zmk,backlight PWM-LED on a free XIAO pad (D0/P0.02)
    so the assert passes and &bl relays brightness to both halves. Only e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
2026-06-28 docs: update MIGRATION_NOTES for the settings-layer fixes
    Replace the stale "TEMP transmutation-only" note: theme switching is restored
    (NICE_VIEW_GEM_TRANSMUTATION_ONLY now a toggle, default n), the waveshare dongle
    relays backlight via a placeholder zmk,backlight node, and output toggling is
    documented as central-only / not-a-bug.
2026-06-28 waveshare dongle: never deep-sleep so waking halves can reconnect
    The XIAO receiver dongle is USB-powered and should stay awake at all times.
    Without CONFIG_ZMK_SLEEP=n it could deep-sleep on idle (dropping BLE), so when a
    half woke from its own sleep there was no central listening for it to reconnect
    to. Pin it off explicitly -- the nano dongle already does this in
    prototype_mk1_dongle.conf, and config/prototype_mk1.conf doesn't set sleep so
    this shield conf takes effect. The halves keep CONFIG_ZMK_SLEEP=y for battery.
2026-06-29 waveshare dongle: fix split reconnect after sleep (battery-fetch buffer starvation)
    Symptom: halves pair fine on first connect, but after a half deep-sleeps it won't
    reconnect to the waveshare dongle until the dongle is power-cycled. The nano
    dongle, running the same battery fetching, never had this.
    Cause: the prospector battery display enables
    CONFIG_ZMK_SPLIT_BLE_CENTRAL_BATTERY_LEVEL_FETCHING, so the central runs GATT
    battery reads/subscriptions to both halves on top of key-position subscriptions.
    At the Kconfig.defconfig default BT_MAX_CONN=5 the dongle exhausts connection/TX
    resources across sleep->reconnect cycles and can't re-accept a waking half until
    reset. The nano dongle avoided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
2026-06-29 waveshare dongle: correct the reconnect fix to BT_ATT_TX_COUNT (ZMK #3156)
    The previous commit blamed BT_MAX_CONN, which was wrong. The real, widely-reported
    cause is ZMK #3156: with CONFIG_ZMK_SPLIT_BLE_CENTRAL_BATTERY_LEVEL_FETCHING on
    (the prospector battery display), subscribing to a peripheral's battery
    characteristic starts a nested GATT CCC discovery that aborts the in-progress
    position-state discovery, so the half links but never subscribes to key positions
    until the dongle is reset.
    ZMK's fix (PR #3216, already in pinned zmk 64daf698) enlarges the ATT TX buffer
    pool via CONFIG_BT_ATT_TX_COUNT (default 10 for a split central) -- the symbol
    newer Zephyr actually uses; the old BT_L2CA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
2026-06-29 docs: ZMK #3156 deep-dive notes — mechanism + Zephyr ATT buffer architecture
    Working research notes (sections 0-3.3): root cause, central.c discovery flow,
    Zephyr BT_ATT_TX_COUNT pool, buffer-demand math.
2026-06-29 docs: ZMK #3156 deep-dive — confirm complete-on-failure against Zephyr gatt.c
    gatt_discover_next() falls through to params->func(conn, NULL, ...) on a failed
    continuation, identical to a clean finish -> ENOMEM is silently read as "complete".
2026-06-30 touch-screen: foundation for 3 touch macro keys (gated; needs wiring + decisions)
    Replace the OPERATOR wpm_meter widget (WPM bars + number + LAYER-NAME text -- they
    live in the same widget) with 3 CST816S touch zones that fire macros. Keep the
    layer dots.
    Adds app/src/touch/touch_input.c: tap decoder + 3-zone hit test + fires
    touch_macro_0/1/2 via zmk_behavior_invoke_binding (on a workqueue). Gated on the
    cst816s DT node, so it compiles to nothing until the controller is declared --
    build stays green. TOUCH-SCREEN-NOTES.md has the activation steps and the open
    decisions (CST816S wiring incl. the D0/backlight-placeholder clash, the 3 macro
    defs, zone calibration, and the prospector-fork butt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
2026-06-30 touch-screen: activate CST816S (D4/D5/D0/D1) + 3 placeholder macro keys
    Wiring confirmed: SDA->D4, SCL->D5 (shared &i2c1), IRQ->D0, RST->D1. D0 was the
    backlight-relay placeholder PWM, so move that placeholder to a free internal pad
    (P0.08) and give D0/D1 to the touch IRQ/RST. Declare cst816s@15 on &i2c1 (this
    flips on app/src/touch/touch_input.c), add CONFIG_INPUT + CONFIG_INPUT_CST816S +
    the macro behaviour, and define touch_macro_0/1/2 (placeholders: Copy/Paste/Lock
    -- customise). Zone bounds are still a guess pending on-hardware calibration
    (every tap logs raw x,y + zone over USB).
2026-06-30 touch-screen: macros -> volume down/mute/up + drop bad CONFIG_ZMK_BEHAVIOR_MACRO
    CI showed the DTS compiled fine (cst816s, &i2c1, the macros, &kp, P0.08 all OK);
    the only failure was assigning CONFIG_ZMK_BEHAVIOR_MACRO, which has no prompt
    (it auto-enables from the zmk,behavior-macro nodes). Remove it. Also set the 3
    test macros to Volume Down / Mute / Volume Up (consumer keys) per request.
2026-06-30 touch-screen: 90 deg CW rotation transform + USB logging for calibration
    Hardware test: taps fire the macros, but the screen renders rotated 90 deg CW vs
    the CST816S panel axes (vol-up came out top, vol-down bottom). Map raw panel
    (tx,ty) -> screen (sx,sy) = (ty, PANEL_W - tx), then zone within the wpm_meter
    rect (10,42,260,90) split into 3 columns (Vol- / Mute / Vol+ left->right). If L/R
    is mirrored it's a one-line sx flip. Enable CONFIG_ZMK_USB_LOGGING so each tap
    logs raw+screen coords + zone (was off, hence no serial data).
2026-07-01 touch-screen: hand taps to a display-UI hook (for the two-screen macro pad)
    Redesign: instead of replacing the WPM widget, tap the main screen to open a
    separate macro screen (3 buttons + Back + timeout). The touch side now maps each
    tap to screen coords and offers it to a weak hook prospector_touch_tap(sx,sy) --
    the prospector fork implements the two-screen UI + timeout and returns true if it
    consumed the tap; otherwise we fall back to the current zone-macro fire, so touch
    keeps working until the fork lands. Fork plan + LVGL thread-safety note in
    TOUCH-SCREEN-NOTES.md.
2026-07-01 touch-screen: fixed 2x3 = 6-cell edge-to-edge touch grid
    Per hardware testing, keep to a max of 6 touch areas: split the whole screen into
    a 2-row x 3-column grid, edge to edge (no gaps -> no mis-inputs). touch_cell()
    maps any screen coord to cell 0..5 (top row 0,1,2 / bottom row 3,4,5); each macro
    button occupies one cell. The prospector_touch_tap hook now takes the cell; the
    fallback fires the 3 test macros from the top row. The macro screen (fork) will
    snap its buttons to the same 6 cells.
2026-07-01 touch-screen: pin prospector fork to f7781fa (touch navigation UI)
    Fork adds the on-screen touch UI (Home grid + debug sub-screens + 5s timeout),
    driven by the app's prospector_touch_tap hook. See TOUCH-SCREEN-NOTES.md.
2026-07-01 touch-screen: pin prospector fork to 555d7b8 (sub Back -> cell 1)
2026-07-01 touch-screen: pin prospector fork to f81d9e7 (uppercase UI labels)
2026-07-01 periph theme: pause switching -> static transmutation-only frame (battery)
    Flip two gem Kconfig defaults so the halves show a single static random
    transmutation frame instead of the animated multi-theme loop:
    NICE_VIEW_ANIMATION y -> n (static frame, no loop)
    NICE_VIEW_GEM_TRANSMUTATION_ONLY n -> y (only transmutation compiled + locked)
    Saves battery (no continuous LVGL animation) and flash (the other 5 themes'
    bitmaps are dropped from the build). The full multi-theme switching system is
    preserved on branch dev/periph-theme; set these back (ONLY=n, ANIMATION=y) to
    restore it. The extra-theme sources + cycle_animation behaviour remain in-tree
    but uncompiled/inert.
    Co-Aut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
2026-07-01 touch-screen: pin fork f4760d3 (restyle + Settings screen w/ brightness+vol)
2026-07-01 touch-screen: Media screen macros (play/pause, prev, next) + pin fork 0f863b2
2026-07-01 touch-screen: pin fork 6abbf3a (MACRO hub + F-keys)
2026-07-01 touch-screen: fix west.yml — restore zmk pin, bump prospector to 6abbf3a
2026-07-01 touch-screen: pass raw coords to touch UI (4x3 numpad support) + pin fork 72081d9
2026-07-01 touch-screen: pin fork 5c8299e (Symbols + Modifiers screens)
2026-07-01 docs: mark touch UI stages B (numpad) + C (symbols/modifiers) shipped [skip ci]
2026-07-01 touch-screen: pin fork 2392ac1 (display brightness device-bind fix)
2026-07-02 touch-screen: pin fork 3366d66 (clear armed mod on hub exit)
2026-07-02 touch-screen: pin fork 8ad5960 (touch key-sends on workqueue, fix boot-variant key corruption)
2026-07-02 docs: §8 boot-variant number-key corruption fix (touch sends off display thread) [skip ci]
2026-07-02 touch-screen: bump LVGL pool to 32K (numpad crash) + pin fork c1f730f (behaviour-queue key sends)
2026-07-02 touch-screen: pin fork 62ba9e5 (fix threading regression: real k_work_submit, not queue_add alone)
2026-07-02 docs: expand review brief with full technical detail + fix self-caught threading regression
    REVIEW-BRIEF.md rewritten to be dense/technical for handoff: exact code, line refs,
    per-issue root-cause chains, fork commit history, verification matrix, and pointed
    review questions. Section 0 documents a regression caught while writing this brief:
    the issue-4 key-send fix (zmk_behavior_queue_add alone) doesn't actually hop threads
    when wait=0 (our only usage) -- it falls through to a synchronous call on the caller's
    thread, reproducing the original display-thread HID race. Corrected with a real
    k_work_submit() to the system workqueue; confirmed green before finalizing docs.
    CODE-REVIEW.md 8 marked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
2026-07-03 reconnect: pin zmk fork c2ca24f (sensor disc-params fix + subscription self-heal)
2026-07-03 dongle: right-size behavior queue (512->64, ~10.7KB RAM) + LVGL pool to 28K
    WO-1. Global config/prototype_mk1.conf sets CONFIG_ZMK_BEHAVIORS_QUEUE_SIZE=512 for
    the halves' long macros; on the dongle that static K_MSGQ costs ~12KB for a queue the
    touch UI fills 2 entries at a time. cmake-args overrides it (global conf merges last,
    so a shield .conf can't). Part of the freed RAM raises the LVGL pool 25000->28672 for
    the WO-10 4x4 numpad. Halves keep 512.
2026-07-03 touch-screen: pin fork d4add50 (WO-9 home KEYS + wider bottom row)
2026-07-03 touch-screen: pin fork 2ebc15a (WO-10 3x3 + 4x4 grids)
2026-07-03 touch-screen: WO-11 trackpad -- pointer/click gestures in touch_input.c + pin fork 5aa0e9b
2026-07-03 touch-screen: pin fork 776dd48 (WO-2 brightness readout, WO-3 mod frame, WO-8 hub labels)
2026-07-03 touch-screen: fix trackpad motion (sample ABS not sync + edge-trigger touch-down) + pin fork 0341078
2026-07-03 dongle: add keymap-sensors node + dummy encoders so waveshare central subscribes to half encoders
    The waveshare dongle overlay had no zmk,keymap-sensors node (only the nano dongle
    overlay did), so ZMK_KEYMAP_HAS_SENSORS was false -> the central never subscribed to
    the peripherals' split SENSOR characteristic -> encoder rotations from the halves
    were dropped. Mirror the nano dongle: sensors node + two dummy EC11 devices on free
    XIAO P1 pins (dongle has no physical encoders; real data arrives over BLE).
2026-07-03 touch-screen: mouse-assist pad (zone clicks + middle scroll, no continuous pointer) + pin fork 7a5fcb8
2026-07-03 halves: default NICE_VIEW_ANIMATION off -> single static frame (setting; =y to re-enable)
2026-07-04 trackpad: whole-screen single-touch gestures -- drag=move, tap=L, 2tap=R, hold-drag=scroll + pin 93c87c2
2026-07-04 touch: far-right scroll lane + left-click window 260->180ms
    - Scroll moved off hold-then-drag onto the far-right strip (TP_SCROLL_ZONE_X=240):
    drag there = wheel, main-area drag = pointer. Removes the hold timer entirely.
    - TP_DTAP_MS 260 -> 180 (snappier left click; tighter double-tap window).
    - Pin prospector fork -> 2bba747 (matching scroll-lane render).
2026-07-05 touch-screen: pin fork 31a6bb4 (visual polish: corner-safe inset, charcoal fills, R44 armed frame, numpad colour-coding, filled armed mods, rounded scroll track)
2026-07-05 touch-screen: pin fork c5683d0 (icon menu labels: home icons, hub cursor-arrow/123/Fn)
2026-07-05 touch-screen: pin fork 6c2fe50 (back buttons -> red up-chevrons)
2026-07-05 touch: styling consistency pass + accurate touch_input.c file header
    Pin fork 3ba7e8a (named hint/lane colours, HOME icons at default width,
    dead draw_cell_pct removed). Rewrite the touch_input.c header -- it still
    described the original 3-macro-zone prototype, not the tap-dispatch +
    trackpad architecture it actually implements.
2026-07-05 docs: PROJECT-REVIEW.md -- state-of-the-codebase map (pre-merge)
    Architecture, three-repo pin discipline, threading invariants, UI design
    language, per-area quality verdicts, deliberate hacks, known trade-offs,
    post-cleanup branch map, doc index.
2026-07-05 docs: PROJECT-REVIEW.md Part II -- file-by-file deep dive [skip ci]
    Every changed file re-read in final merged form: touch_input.c gesture
    machine, fork status_screen.c (SPSC ring + mailbox analysis), brightness.c
    (ALS dead-code bugs flagged), zmk fork central.c (#3156 fix verified on both
    walk-end paths), DT/conf/build glue. Findings labelled bug/stale/theoretical/
    design; open-items table in section 16 (headline: USB logging outlived
    calibration and leaks touch-typed keys over USB CDC; fix SHA drift for the
    zmk fork pin -- c2ca24f, not 62ba9e5).
2026-07-05 fix deep-dive findings: USB logging off, comment sweep, ALS fade fix (fork)
    PROJECT-REVIEW.md section 16 items 1-3:
    1. CONFIG_ZMK_USB_LOGGING=n -- calibration is long done, and the INF tap logs
    revealed touch-typed keys over USB CDC. Re-enable temporarily to watch the
    reconnect marker during sleep/wake verification.
    2. Comment sweep: "3 macro-key zones" drift in the overlay header + conf +
    CMakeLists; "three macros" block (there are six); 4x3 -> 4x4 pool note.
    3. Pin fork abad650: brightness.c ALS fade loop rewritten (uint8_t < 0 dead
    check, bound overshoot) -- compiled out on our build, fixed for the day an
    APDS9960 is fitted.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
2026-07-05 comment cleanup + CHANGES.md; pin fork 98a508d (same cleanup there)
    Slim the history-heavy comments in touch_input.c to what the code needs;
    the calibration story, hardware discoveries and design rationale move to
    CHANGES.md (one per repo -- the prospector fork got its own) so the context
    stays available for future edits.
2026-07-05 touch: trackpad pointer acceleration, adjustable from the settings screen
    Threshold accel curve in touch_input.c: per-sample deltas up to 3px stay 1:1,
    gain ramps linearly with speed above that and saturates at the level cap.
    Five levels (OFF/1/2/3/MAX, default 2), x256 fixed point with per-touch carry
    so slow diagonals keep their sub-pixel travel. Replaces the flat TP_SENS
    multiplier. Level is adjusted from the settings screen bottom row via new
    prospector_touchpad_accel_get/step hooks (pin fork 4959578 -- the volume row
    moved out; volume was always duplicated on MEDIA).
2026-07-05 touch-screen: menu timeout 5s -> 30s; swipe-to-back dropped (pin fork e9aeaff)
    Hub and trackpad remain exempt from the idle timeout (explicit exit only).
2026-07-05 touch: trackpad sensitivity 0-10 (default 5 ~4x) + 180deg rotate flip
    - Replace the acceleration curve with a flat sensitivity multiplier:
    level 0..10, default 5 ~= 4x movement, x256 with per-touch carry.
    prospector_touchpad_accel_* -> _sens_*.
    - prospector_touch_set_flip(): the fork calls this when the display is
    rotated 180deg from the settings screen; panel_to_screen_x/y invert to
    keep taps + trackpad aligned to the rotated image.
    - Pin fork 1353f4e (menu swap, settings rework, rotate button, trackpad
    render tidy).
2026-07-05 docs: consolidate the 8 docs into information.md + issues.md
    Combine CHANGES / CODE-REVIEW / IMPROVEMENT-PLAN / MIGRATION_NOTES /
    PROJECT-REVIEW / REVIEW-BRIEF / TOUCH-SCREEN-NOTES / ZMK-3156-DEEP-DIVE into
    two files: information.md (current, still-relevant reference) and issues.md
    (issue history + root cause + fix; unsolved items under a leading "Unsolved"
    heading). Repoint the in-code/config doc references to the two new files.
2026-07-06 verification pass: fix two stale comments (pin fork post-doc-consolidation)
    touch_input.c corner-exit comment said "exit to the hub" (it is HOME since
    the menu swap); fork CHANGES.md pointed at the pre-consolidation doc names.
2026-07-06 touch-screen: settings gets a readout row (pin fork 5060fa1)
    3x3 settings: +/- rows keep the end-stop grey-out, new bottom row shows
    icon + live value per column (GPS-cursor + sensitivity, eye-open +
    brightness %% -- LVGL has no sun glyph).
2026-07-06 touch: 4-orientation support (0/90/180/270) for the trackpad + tap mapping
    prospector_touch_set_flip -> prospector_touch_set_orientation(0..3). The
    panel->screen transform becomes a 4-case switch (280x240 landscape at
    0/180, 240x280 portrait at 90/270; rot 0 = calibrated baseline). Scroll
    lane generalised to logical >= 240 along the long axis: right strip in
    landscape, bottom strip in portrait where the lane lies horizontally and
    swipe right = scroll down. Pin fork abea77c (portrait-aware touch UI
    layouts + the 4-step rotate button).
    If the two portrait orientations come out swapped vs the display on
    hardware: swap cases 1/3 in the transform AND the middle entries of
    rot_to_panel[] in the f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
2026-07-06 touch-screen: trackpad exit glyph -> X (pin fork cee7793)
2026-07-06 touch-screen: st7789v orientation-cycle margin fix (pin fork 4876f11)
2026-07-06 touch: 3x faster trackpad scrolling (TP_SCROLL_PX 18 -> 6)
    One wheel tick per 6px of lane travel instead of 18 -- a full swipe of the
    lane now produces ~46 ticks instead of ~15.
2026-07-06 switch to the standalone zmk-waveshare-touch module
    The prospector fork content moved to a fresh repo
    (H0N3YC4T/zmk-waveshare-touch, pin dcedbf3): OPERATOR layout + touch UI +
    patched st7789v driver, trimmed of the unused upstream layouts/fonts, with
    carrefinho credited in its README and LICENSE. touch_input.c moves into the
    module too, so the gesture driver and the UI it drives live in one repo --
    this repo is back to pure keyboard config. The old fork stays on GitHub as
    the history archive (old pins still resolve).
2026-07-06 fix west pin: real zmk-waveshare-touch SHA (a37a20e tip)
    The previous pin was a fabricated full SHA -- only the short prefix was
    ever printed at push time and the rest was invented, so west update died
    with "upload-pack: not our ref" on every target. Pin the verified tip
    (rev-parse, not reconstruction). Verified locally with west update before
    pushing this time.
2026-07-06 docs: Touch-UI navigation map moves to the module (pin 773de1d)
    The mermaid diagram belongs with the UI it documents; it now renders on
    GitHub in zmk-waveshare-touch/docs/. touch_input.c had already moved in
    the module switchover -- with this, everything touch-specific lives in the
    module and this repo is keyboard config + keyboard docs only.
2026-07-06 touch-screen: pin module 773de1d (Touch-UI nav map now in the module docs)
2026-07-06 touch-screen: settings readout row 50/50 (pin module 2f90f8a)
2026-07-06 touch-screen: pin module b482fef (god-file split, no behaviour change)
2026-07-06 touch-screen: pin module f092b76 (tree flatten + registry-driven views)
2026-07-07 touch-screen: pin module b071680 (NORMAL-page portrait reflow)
2026-07-07 touch-screen: pin module 3372b57 (smaller mod font + battery under output)
2026-07-07 touch-screen: pin module e478ea1 (HOME 6-button menu + numpad HID codes)
2026-07-07 touch-screen: pin module 53b6826 (smaller mod font + battery under output)
2026-07-07 touch-screen: pin module b4a2eef (mod-key row width fix)
2026-07-07 touch-screen: pin module 75ff562 (mod-key width fix, portrait-only)
2026-07-07 touch-screen: pin module a918d23 (remove orphaned Kconfig + rotation landmine)
2026-07-07 touch-screen: pin module 71cda53 (dead code + stale comment cleanup)
2026-07-07 touch-screen: pin module ae29619 (widgets cleanup)
2026-07-07 touch-screen: pin module 596a6af (trackpad drag-lock gesture)
    Adds tap-then-hold-and-drag (drag-lock) support; also refreshes the
    trackpad/rotation section of docs/information.md, which had drifted
    stale across several prior sessions.
2026-07-08 touch-screen: pin module e0aafa5 (single-source seam constants) + review map
    TP_SCROLL_ZONE / sens-max / brightness-clamp each defined once in
    touch_ui.h instead of duplicated across the seam with must-match
    comments. Adds docs/review-map.md: a guide for manually reviewing all
    surviving changes since the Zephyr 4.1 / LVGL 9.3 uplift (cd13044),
    tagged by review intensity.
2026-07-08 touch-screen: pin module cab5681 (Touch-UI nav map rebuild + comment fix)
2026-07-08 zmk pin: cfa75c3f (comment-density trim in the #3156 fix, no code change)
    Same central.c logic; the fix's paragraph commentary is reduced to
    one-liners with removed calls left commented out in place.
2026-07-08 zmk pin be3b4c6 (restore INF reconnect marker) + PAD/colour docs
    The fork's subscription-success log went back to INF -- it is the
    hardware-verification marker for the reconnect fix and LOG_DBG is
    invisible over USB CDC. Docs: PAD screen (keymap-bound macro buttons)
    + settings colour roles (green +, yellow -, purple readouts).
2026-07-08 zmk pin 9a4ae7b (PR squash of the #3156 fix; old pin orphaned by the rewrite)
2026-07-09 Remove blank line in prototype_mk1.keymap
    Remove unnecessary blank line at the start of the file.
2026-07-11 extract nice!view display into the nice-view-mk1 module (gem -> mk1)
    boards/shields/nice_view_gem, the cycle_animation behavior/event
    (app/ + include/) and the root CMakeLists move to the standalone
    H0N3YC4T/nice-view-mk1 module, tracked revision: main in west.yml like
    the touch module. Shield renamed nice_view_mk1 in build.yaml; the
    dev/periph-theme backup branch stays here as a frozen design reference.
2026-07-11 rename repos: keyboard -> prototype-mk1, touch module -> dongle-mk1
    GitHub repos renamed for consistent mk1 naming (old URLs redirect);
    west.yml project + docs follow. Shield names unchanged.
2026-07-11 Update configuration for Prototype Mk1 dongle
2026-07-11 confs: strip inapplicable/misplaced options from the prototype_mk1 shield
    The shared shield conf shrinks to the encoders (everything else it
    carried was commented-out copies of options that are actively set in
    config/prototype_mk1.conf or the per-target confs, plus NICE_OLED_*
    junk from another project). Per-target confs reorganised, the wrong
    'animates by default' peripheral comments corrected (module default is
    a static frame), and the waveshare conf's stale pre-extraction touch
    driver path updated. No active option values changed.
2026-07-11 docs: correct information.md against the declarative touch UI
    SETTINGS is a 3x6 spanned grid (old 3x3 cell numbering was stale), CALC
    is 3 pages with brackets/%/!/binary, CALC also defines holds (clear /
    percent), MODIFIERS now idle-times-out too, and the palette is
    role-named (COLOR_PRIMARY/ACCENT/ALERT) in the module's
    display_colors.h since the rework.
2026-07-11 docs: information.md sections 2-3 caught up with reality
    Section 2 still described the pre-extraction repo set (prospector fork
    as the UI repo, touch_input.c in this repo, everything SHA-pinned,
    _touchref clones); section 3 described the weak-symbol seam and the old
    tp_flip 180-degree transform. Both replaced with the current four-repo
    layout, branch tracking for modules, and the 4-case rotation transform
    inside dongle-mk1.
2026-07-11 module.yml: rename the zephyr module to prototype-mk1 (last stale-name holdout)
2026-07-12 extra files
    [keyboard.3mf]
2026-07-12 wire theme switching: nvcycle node name + all themes on the halves
    The cycle_animation behavior was already GLOBAL-locality, but ZMK's BLE
    split relay truncates behavior device names to 8 chars + NUL -- the
    15-char node name arrived as "cycle_an" and the peripheral lookup
    failed silently. Node renamed to nvcycle (the C label and every
    &cycle_animation binding are unchanged). Halves compile all six themes
    (TRANSMUTATION_ONLY=n) so switching is visible; static-frame mode is
    kept, so NVC_NEXT/PREV shows a random frame of the next theme and
    NVC_PAUSE reshuffles. west.yml consumes nice-view-mk1@dev (battery
    tick) for this test cycle -- merge dev to main after hardware confirm.
2026-07-12 west: nice-view-mk1 back to main (dev merged; theme switching hardware-verified)
2026-07-12 docs: theme switching hardware-verified
2026-07-13 settings layer: NVC_SHUF on v (random frame in current theme)
2026-07-13 wire ZMK Studio on the dongle (usb-uart snippet, unlock on settings layer)
2026-07-13 Delete stale docs: review-map.md and crystal.c
    Remove two obsolete documentation files: docs/review-map.md (historical code-review snapshot from 2026-07-08) and docs/themes/crystal.c (large generated LVGL bitmap/theme asset). These files were a stale snapshot and generated assets no longer needed in the repository; deleting them cleans up disk noise and avoids confusion about current state.
2026-07-14 TEMP diagnostic build: dongle usb logging + 1-min half sleep (revert after reconnect debug)
    [keyboard.3mf]
2026-07-14 halves: sleep off, 60s idle (battery experiment)
2026-07-14 dongle: 25% draw buffers (frees 67K RAM; render in 4 strips, SPI-bound so same speed)
2026-07-15 west: zmk charging-state characteristic (fix/sleep-reconnect)
2026-07-15 west: repin zmk charging commit
2026-07-15 rebuild: charging array fix
2026-07-15 rebuild: charge bolt centred
2026-07-15 rebuild: charge bolt centred + icon cleanup
2026-07-15 rebuild: portrait slot height
2026-07-18 dongle: freeze-hunt batch - fork pin w/ workqueue scan restart, HCI event buffer headroom, deeper position queue, logging capture build
2026-07-19 zmk pin -> battery/charge-state (upstream main + charging only; connection-fix experiments retired); rebuild w/ A8 icons
2026-07-20 keymap: display-name on custom behaviors/macros for ZMK Studio labels (sensor-rotate binding lacks the prop - encoders skipped)
2026-07-20 docs: automated keymap render (keymap-drawer + resvg) - categorized colors, symbol legends, encoder knob widgets; CI workflow regenerates keymap_raw.{svg,png} on keymap changes
2026-07-20 keymap render: resolve sensor-rotate behaviors from their DT bindings (was hardcoded, missed the undo/redo direction swap)
2026-07-20 keymap render: dynamic sensor-rotate legends; output renamed keymap_raw -> keymap
2026-07-20 keymap render: dark mode (uniform dark keys, category-colored legends, muted-red held), circular encoder knobs, explicit background rect
2026-07-21 split link: 3.0ms connection interval (nordic sub-spec low-latency mode), slave latency rescaled to 76 to keep idle power unchanged
    Keypress latency ~6ms -> ~3.8ms; the BLE hop was ~62% of the controllable budget.
    Below interval 6 the controller switches to a 500us unit with a +1 offset, so
    INT=5 is 3.0ms and the scale is discontinuous with 7.5ms. Deliberately NOT setting
    BT_CTLR_ASSERT_OVERHEAD_START=n: its help warns that silently skipping delayed
    radio events can cause supervision timeouts, which is the failure mode to avoid.
2026-07-21 pcb files
    [bom.csv, designators.csv, positions.csv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]
